SimonD5/GyroBot/Documentation/rapport/Gyrobot_meeting_report.pdf

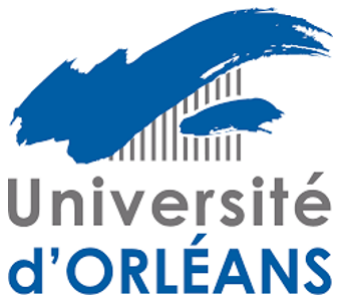
[picture p5: figure]
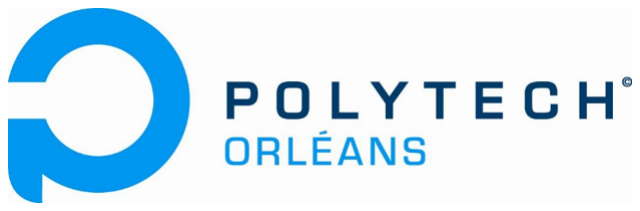
[picture p6: figure]

# Gyrobot meeting report

Alexandre Vanpeperstraëte–Bourgueil Isam Ben-Haddou
Maud Haas
Simon Drapeau

4A GPSE

Quentin Legros

Teacher at Polytech specialising in GPSE

Gyrobot project
Quentin LEGROS
S7 2026

## Contents

1 Meeting on 21 September 2026 | 2
2 Meeting on 2 October 2026 | 2
3 Meeting on 16 October 2026 | 2
4 Meeting on 6 November 2026 | 2

Alexandre Vanpeperstraëte–Bourgueil, Isam Ben-Haddou, Maud Haas, Simon Drapeau

Gyrobot project
Quentin LEGROS
S7 2026

## 1 Meeting on 21 September 2026

At this first meeting, we presented our project and outlined where we were in the process. We also discussed the technical choices regarding the components, particularly the reasoning behind them.

Mr Legros also advised us to carry out a simulation whilst we awaited delivery of the components, to avoid wasting time and, above all, to save time for the next stages, particularly regarding the PID.

It was agreed that, from this Friday onwards, meetings would be held every two weeks unless otherwise requested by the group or Mr Legros.

## 2 Meeting on 2 October 2026

At this second meeting, we presented a simulation of the robot balancing on its two ‘wheels’. We also drafted the use case report.

We also requested a switch to GitHub instead of GitLab, as the latter blocks connections from outside the university network. Furthermore, GitLab will no longer be accessible (and is not accessible at the time of writing this report) and will no longer be usable for the project.

## 3 Meeting on 16 October 2026

This meeting demonstrated the excellent progress made on the project. Indeed, a miniature robot has been built (as required for the next stage of the project), which can balance on two wheels, albeit with a few glitches. Mr Legros therefore gave us some pointers on how to resolve these issues.

A working remote control was also demonstrated. It is already able to control the small robot and allows us to carry out tests for the main robot.

## 4 Meeting on 6 November 2026

At this meeting, we informed Mr Legros that the PCB and the 3D-printed shell for our main robot are being manufactured as planned.

Gyrobot project
Quentin LEGROS
S7 2026

Finally, to save time, he advised us to actively divide up the tasks throughout the project, namely drafting the various deliverables, assisting with the development and implementation of the LiDAR, and preparing for the upcoming presentations.
