SimonD5/GyroBot/Documentation/rapport/Gyrobot_use_cases_report_fait_avec_latex.pdf

# Gyrobot use cases report

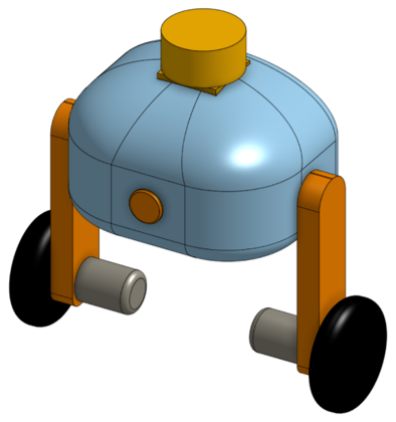
[picture p7: figure]

Alexandre Vanpeperstraëte–Bourgueil Isam Ben-Haddou
Maud Haas
Simon Drapeau

4A GPSE

Quentin Legros

Teacher at Polytech specialising in GPSE

Gyrobot project
Quentin LEGROS
S7 2026

## Summary

1 Introduction | 2
2 General description of the robot | 3
3 User experience | 4
4 Algorithmic operation | 6
5 Specifications | 7
6 Retro planning (Gantt) | 8
7 Validation testing and functional analysis | 10
8 Description of technical choices | 20
9 Gyrobot | 25
10 RSE | 29
11 FMEA Table | 30
12 Conclusion | 33
13 Appendices | 34

Alexandre Vanpeperstraëte–Bourgueil, Isam Ben-Haddou, Maud Haas, Simon Drapeau

Gyrobot project
Quentin LEGROS
S7 2026

## 1 Introduction

As part of our fourth year at Polytech Orléans engineering school, we are required to undertake one of the projects provided or to propose one of our own. We therefore proposed to build a robot that balances on two wheels using a gyroscope: the Gyrobot.

It is a compact, self-balancing, two-wheeled robot, designed to operate in environments where mobility, accessibility, and autonomous navigation can pose challenges.

The project aims to explore the design of a small, lightweight robotic platform capable of maintaining its balance on two wheels, whilst serving as a basis for future applications such as mapping, exploration, and assistance in challenging environments.

In this report, we will cover the general description of the robot, the user experience, the algorithmic operation, the use case, and finally the Gantt chart.

Gyrobot project
Quentin LEGROS
S7 2026

## 2 General description of the robot

The robot can be divided into three main parts:

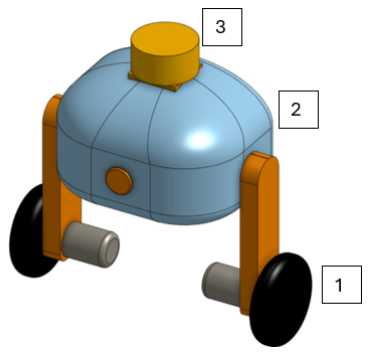
[picture p8: figure]

Figure 1: 3D sketch of the Gyrobot

The lower part of the robot, the motors, wheels and ‘legs’ marked 1 in the image below. This part must be robust so it can withstand the rigours of various types of terrain, as well as the impacts caused by the robot’s movement.

The central section of the robot, labelled 2, contains the various components required for movement, balance, and processing of lidar data. It also houses the battery needed to power the robot. The biggest challenge with this section will be managing the weight and its distribution.

The upper section of the robot, designated 3, will house a tool required for mapping. This section must include at least two different tools in order to make the robot more versatile.

The project also includes a user interface to display the data transmitted and processed by the robot.

Gyrobot project
Quentin LEGROS
S7 2026

## 3 User experience

This section focuses on what the user needs to do to use our product.

### 3.1 Essential feature of the map

The Gyrobot will need to move around, map its surroundings, process the data and send it back to a user interface. It will also need to receive the commands required to move the robot. That is why we have opted to use two cards, to avoid a potential data overload if there were only one card.

A map will need to manage commands relating to the robot’s movements. It must therefore:

- To be able to transmit the commands required for movement wirelessly
- Transmit data such as speed, the robot’s angle relative to the ground and remaining battery charge
- Heat resistance
- To be fairly small in size
- To be energy-efficient

The second card will be responsible for processing mapping-related data and sending it to our HMI. It will therefore need to:

- To have sufficient computing power to process lidar data
- To be able to communicate wirelessly with the HMI
- Heat resistance
- To be fairly small in size
- To be energy-efficient

There are various boards to choose from: an Arduino, an ESP 32, a Raspberry Pi, an STM 32 and a Tensy.

The selection of the various components is carried out in: Description of technical choices

Gyrobot project
Quentin LEGROS
S7 2026

### 3.2 HMI

We also need to develop a user interface to display the data returned by the robot. The image below was created partly with the help of generative AI.

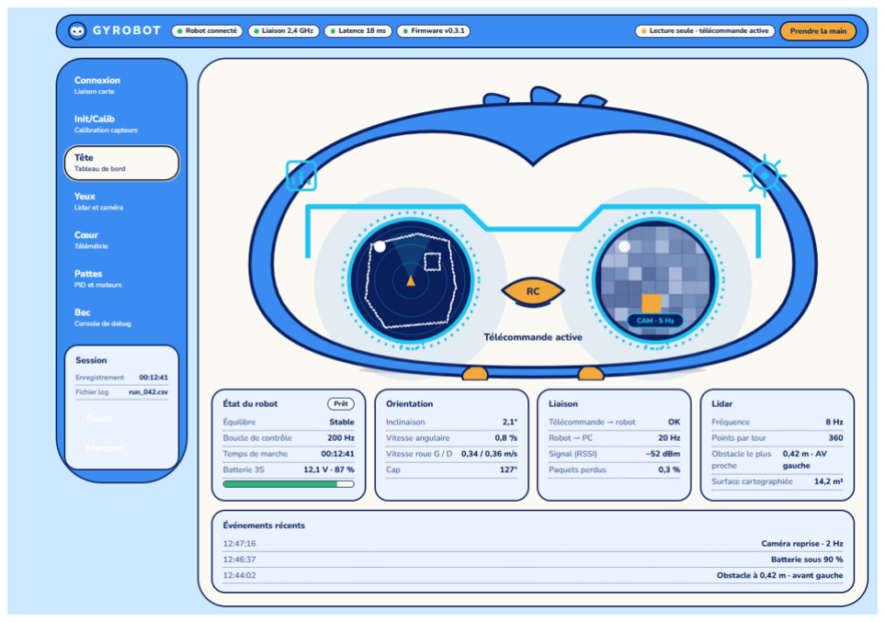
[picture p9: figure]

Figure 2: Image from the IMH

The user interface will comprise several sections/tabs to monitor the various values and lidar data returned by the robot. This penguin-themed user interface was chosen by our team and is purely for aesthetic purposes.

The layout and the data displayed in the user interface are subject to change.

Gyrobot project
Quentin LEGROS
S7 2026

## 4 Algorithmic operation

### 4.1 Flow chart

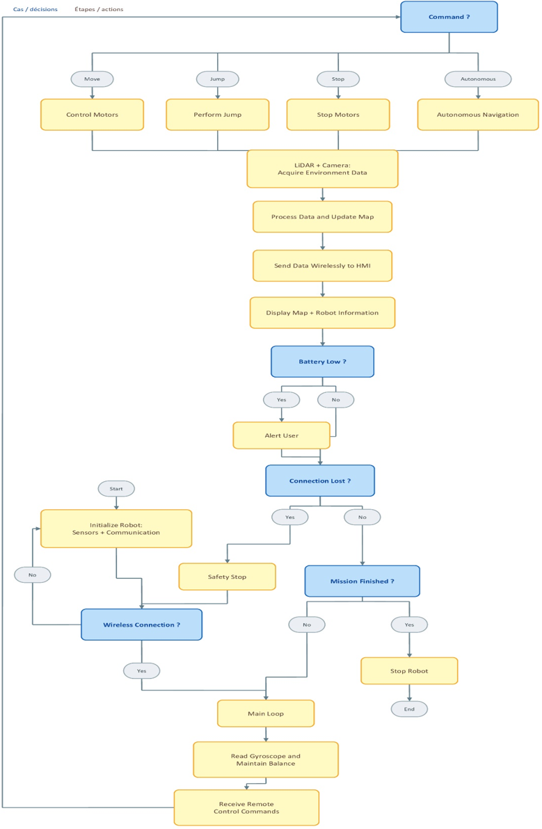
[picture p10: figure]

Figure 3: Flowchart of the Gyrobot

This flowchart explains how the programme’s algorithm works.

Gyrobot project
Quentin LEGROS
S7 2026

## 5 Specifications

In order to draw up the specifications correctly, we need to identify the project’s requirements and expectations. As regards expectations, we need to build a robot that can balance on two wheels, is capable of mapping its environment, and can interact via a remote control and a user interface that displays the robot’s data. As for the requirements, we have defined two types: primary requirements, which are necessary for the robot’s basic operation, and secondary requirements, which serve to make the robot more versatile.

The primary requirements align with our expectations, as we have set them ourselves.

As for the secondary requirements, we wish to develop a user interface and a robot resembling a penguin, to have a rechargeable battery, and for the lidar to be replaceable with a high-resolution camera.

Gyrobot project
Quentin LEGROS
S7 2026

## 6 Retro planning (Gantt)

Phase Task Owner Start End Duration (days) 31/08 07/09 14/09 21/09 28/09 05/10 12/10 19/10 26/10 02/11 09/11 16/11 23/11 30/11 07/12 14/12 21/12 28/12 04/01 11/01

T0: Project kickoff 2026-09-03 2026-09-03 1

Update GitLab All 2026-09-03 2026-10-05 33 Write the ReadMe Simon 2026-09-03 2026-09-08 6
Create the various diagrams All 2026-09-04 2026-09-22 19
Identify the project's HVA functions All 2026-09-15 2026-09-29 15

Specifications document Issam 2026-09-21 2026-09-30 10
CSR approach Maud 2026-09-30 2026-10-04 5 Write the T1 technical report (Audit) Alexandre 2026-09-28 2026-10-05 8
Prepare the PPT (critical path) All 2026-09-30 2026-10-05 6

T1: Audit 2026-10-06 2026-10-06 1
Detail the Phase T1 Gantt chart To be defined 2026-10-06 2026-10-07 2

Select components and place order Maud & Simon 2026-09-29 2026-10-15 17

Generate and evaluate technical solutions for each function To be defined 2026-10-06 2026-10-19 14
Advance system's 3D mechanical design (sizing, architecture) To be defined 2026-10-13 2026-11-03 22

Gestion PCB (Conception & Routage) To be defined 2026-10-06 2026-10-26 21

Validation PCB To be defined 2026-10-27 2026-11-09 14
Justify chosen technical solutions + CSR component To be defined 2026-11-03 2026-11-19 17
Preliminary HVA review + technical report update (PDR) To be defined 2026-11-02 2026-11-20 19
T2: PDR 2026-11-20 2026-11-20 1
Detail the Phase T2 Gantt chart To be defined 2026-11-20 2026-11-21 2

Test composants To be defined 2026-11-23 2026-11-27 5
Manufacture / Assemblage Robot To be defined 2026-11-30 2026-12-04 5

Tenir debout (Asservissement / Équilibrage) To be defined 2026-12-07 2026-12-11 5

LiDAR - Acquisition & Traitement To be defined 2026-11-23 2026-12-04 12
Caméra 3D & Écriture code Python (récup data) To be defined 2026-11-23 2026-12-04 12

Intégration fonctionnalités Caméra + LiDAR To be defined 2026-12-07 2026-12-18 12
Rendre fonctionnelle l'IHM + Rapport IHM To be defined 2026-12-07 2026-12-18 12
Tout intégrer (Matériel + Logiciel) To be defined 2026-12-21 2027-01-01 12

Test each function against requirements (compliance matrix) To be defined 2026-12-15 2027-01-05 22
Fix identified defects To be defined 2027-01-04 2027-01-07 4

Prepare HVA demonstration (CDR) + marketing video (English) To be defined 2026-12-15 2027-01-07 24 Write final S1 technical report To be defined 2026-12-15 2027-01-07 24
T3: CDR + Mini trade show 2027-01-08 2027-01-08 1

Gyrobot Gantt Chart

T0 Kickoff: 09/03/26 | T1 Audit: 10/06/26 | T2 PDR : 20/11/26 | T3 CDR + Mini trade show : 08/01/27

Phase A: Scoping and Analysis Phase B: Design and Technical

Solutions

Phase C: Integration and HVA

Validation

Figure 4: Gantt chart (updated on 21 September 2026)

Gyrobot project
Quentin LEGROS
S7 2026

This schedule will be updated as we make progress on the project. In terms of organisation, our biggest challenge is that we only have three months to build a prototype.
This means we need to have a very precise and rigorous organisational structure.

Gyrobot project
Quentin LEGROS
S7 2026

## 7 Validation testing and functional analysis

### 7.1 Functional analysis

### 7.1.1 Horned beast diagram

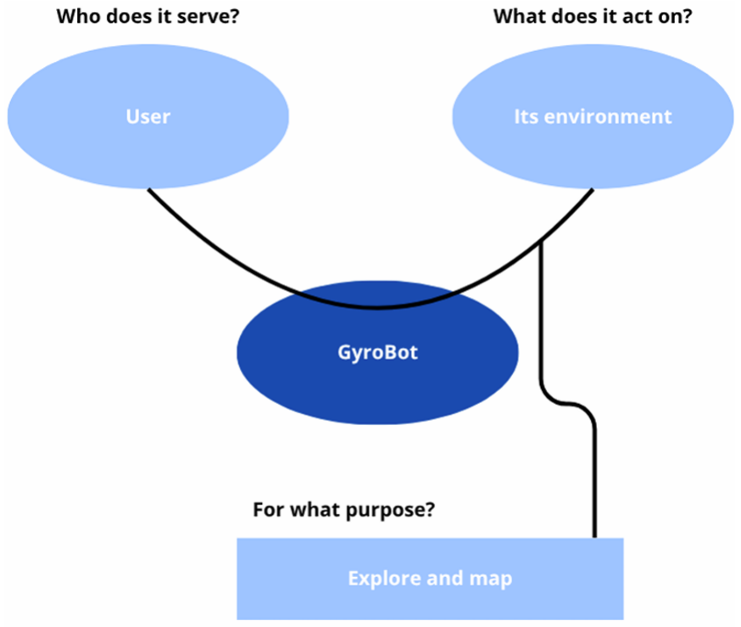
[picture p11: figure]

Figure 5: Horned beast diagram

The horned beast diagram provides a clear understanding of a user’s needs before designing a product or service. In our case, our aim is to map an area and create a map of it, all using the Gyrobot. It will be controlled by a user in various environments, both indoors and outdoors.

Gyrobot project
Quentin LEGROS
S7 2026

### 7.1.2 Octopus diagram

Here are the various block diagrams showing the critical and main functions.

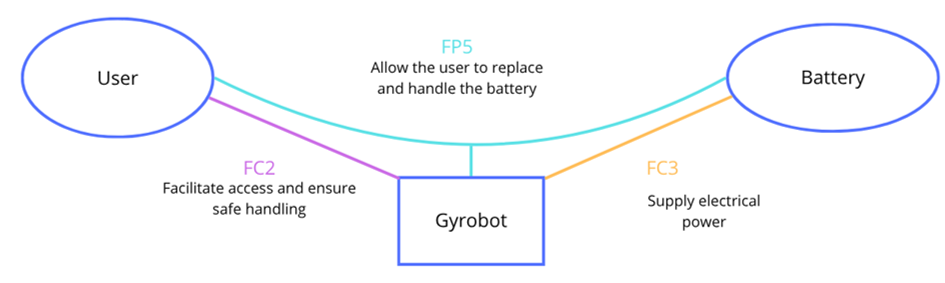
[picture p12: figure]

Figure 6: Energy recharge phase

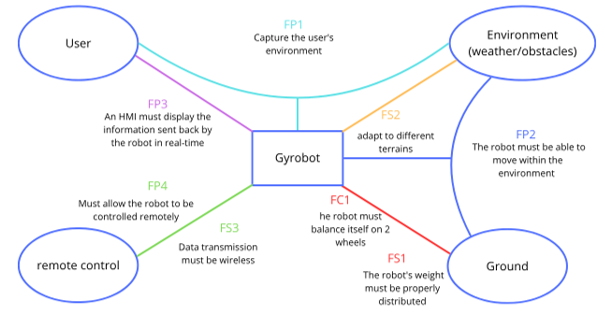
[picture p13: figure]

Figure 7: Usage phase

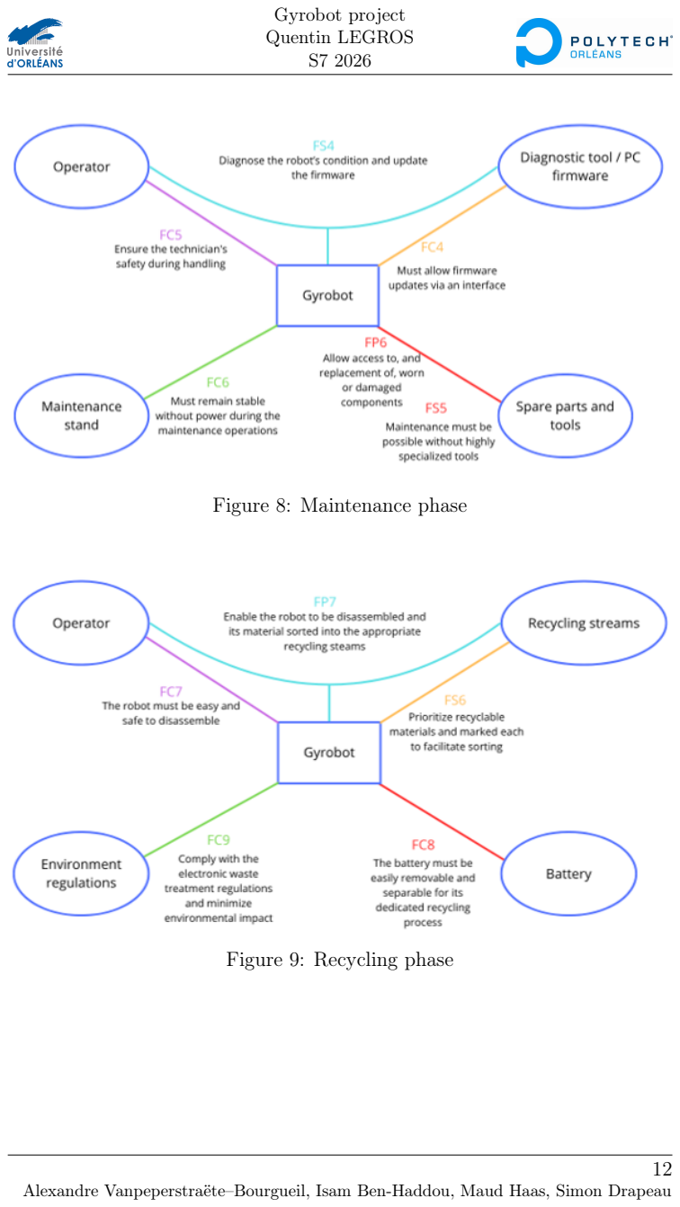
[picture p14: page 13]

Gyrobot project
Quentin LEGROS
S7 2026

Figure 8: Maintenance phase

Figure 9: Recycling phase

Gyrobot project
Quentin LEGROS
S7 2026

### 7.1.3 FAST diagrams

Using octopus diagrams, we obtain the FAST diagram.

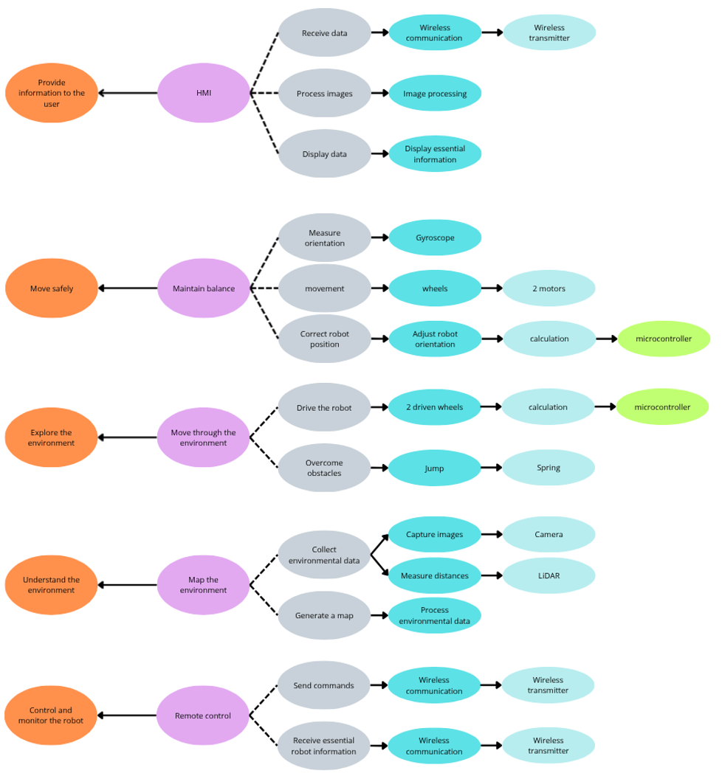
[picture p15: figure]

Figure 10: Fast diagrams

The FAST diagram enables us to work our way from our requirements to the technical solutions.

Gyrobot project
Quentin LEGROS
S7 2026

### 7.2 Functional table

Using the FAST diagram, we can draw up a functional diagram of the Gyrobot.

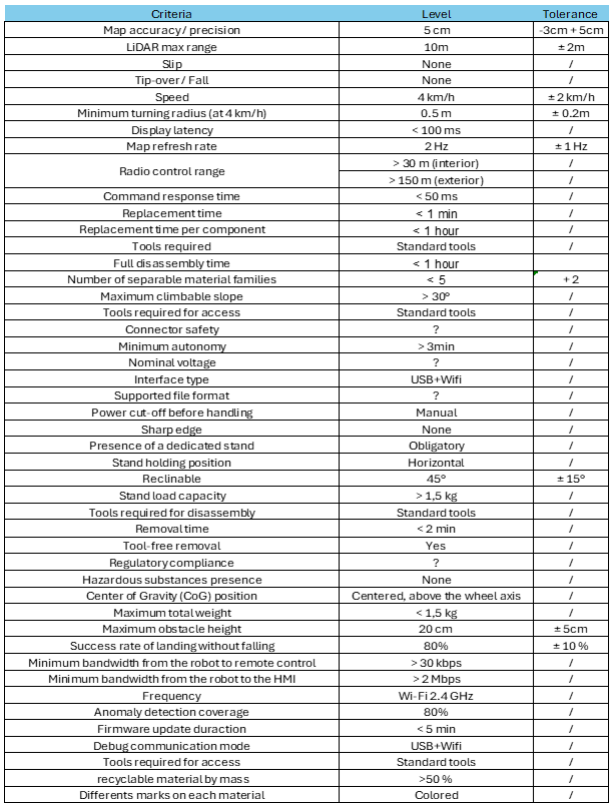
[picture p16: figure]

Figure 11: Functional analysis

Gyrobot project
Quentin LEGROS
S7 2026

### 7.3 Validations test

To avoid building the robot from scratch only to find that it doesn’t work without knowing why, we need to put validation tests in place to test each major component of the robot separately.

Here are the various tests that have been put in place:

- Connection and acknowledgement test
- Command response time test
- Remote control range test
- Communication reliability test
- Data rate and range test to the computer
- Lidar range test
- Map accuracy test
- Display latency and map refresh rate test
- Balance test
- Speed and turning radius test
- Weight test
- Battery replacement test
- Simultaneous operation test

### 7.3.1 Connection and acknowledgement test

We send commands from the remote control and check that the ESP32 receives them and sends back an acknowledgement. The test is successful if the green dot remains lit on the remote control.

### 7.3.2 Testing the response time of the control system

The remote control records the time a command is sent and the time the acknowledgement is received. The difference gives the response time, which

Gyrobot project
Quentin LEGROS
S7 2026

must be less than 50 ms. The statistics are displayed in a ‘Statistics’ tab on the remote control, and the mean and standard deviation are monitored.

Gyrobot project
Quentin LEGROS
S7 2026

### 7.3.3 Remote control range test

Gradually move the remote control away from the robot, first indoors and then outdoors, with and without obstacles. Record the distance once the connection is lost. The test is successful if the connection remains stable for more than 30 metres indoors and more than 150 metres outdoors. Check the green dot and the number of lost packets in the ‘Stats’ tab on the remote control.

### 7.3.4 Transaction reliability test

Leave the robot to run for 1 minute, whilst moving it around, and note the number of lost packets in the ‘Statistics’ tab on the remote control, then in the HMI. The test is successful if the loss rate remains below 5 per cent.

### 7.3.5 Testing the data rate and range to the computer

Measure the actual data transfer rate between the Raspberry Pi and the computer. The data transfer rate must remain above 2 Mbps.

### 7.3.6 Lidar range test

An obstacle is placed at increasing distances from the robot, and we check whether it appears on the HMI map. The maximum range should be 10 m ± 2 m. We compare the distance displayed on the HMI with the measured distance to verify reliability at each distance.

### 7.3.7 Map accuracy test

We have a room or object mapped, having first measured its dimensions. We then compare the dimensions shown on the map with those in reality. The test is deemed successful if the deviation falls within the tolerance specified in the specifications (5 cm, -3 / +5 cm).

Gyrobot project
Quentin LEGROS
S7 2026

### 7.3.8 Testing the display latency and refresh rate of the graphics

card

The Raspberry Pi stamps each data point with a timestamp upon acquisition, and the computer compares this timestamp with the display time, after synchronising the two. The latency must be less than 100 ms. To calculate the refresh rate, we count the number of map updates over 10 seconds, which should give 2 Hz ± 1.

### 7.3.9 Balance test

The robot is left stationary and then set in motion for several minutes, whilst being given gentle nudges. The robot must neither fall over nor slip. We also check that it can climb up and down a slope steeper than 30°.

### 7.3.10 Speed and turning circle test

A distance of 10 m is marked out and the time taken to cover this distance at maximum speed is recorded: 4 km/h corresponds to approximately 9 s, with a margin of error of ± 2 km/h. To test the cornering, the robot is made to trace a circle, and its radius is measured (0.5 m ± 0.2 m). A visual check is carried out to ensure there is no slippage.

### 7.3.11 Weight test

We weigh the complete robot, including the battery, on a set of scales: it must weigh less than 1.5 kg.

### 7.3.12 Battery replacement test

Someone who did not design the robot replaces the battery, timing the process, without using any tools. The replacement must take less than a minute. A check is then carried out to ensure the robot restarts correctly.

Gyrobot project
Quentin LEGROS
S7 2026

### 7.3.13 Simultaneous testing

We run everything at the same time: balance, movement, controls, Lidar, camera and data transmission to the computer. We monitor the stats tabs for several minutes. The test is successful if the robot does not fall over and if all the previous criteria are met.

Gyrobot project
Quentin LEGROS
S7 2026

## 8 Description of technical choices

### 8.1 Remote control

Criterion | Level | Unit | Source
Minimum radio range (indoor) | 30 | m | Specifications : function table (FP4)
Minimum radio range (outdoor) | 150 | m | Specifications : function table (FP4)
Maximum response time of the control | 50 | ms | Specifications : function table (FP4)
Control element | No. of elements | Analog. channels / element | Digital inputs / element | Digital outputs / element | I2C pins / element | Total analog | Total digital inputs | Total digital outputs | Total I2C pins | Role on the robot (to be completed)
2-axis joystick (KY-023) | 2 | 2 | 1 | 0 | 0 | 4 | 2 | 0 | 0 | Joystick 1 : forward/backward (Y axis) + turn right/left (X axis) ; Joystick 2 : tilt right/left (X axis) + lower/raise (Y axis)
Slide potentiometer | 3 | 1 | 0 | 0 | 0 | 3 | 0 | 0 | 0 | Adjustment of the robot's 3 PID controller gains (P, I, D)
Rotary potentiometer | 1 | 1 | 0 | 0 | 0 | 1 | 0 | 0 | 0 | Adjustment of the maximum travel speed
Push button | 5 | 0 | 1 | 0 | 0 | 0 | 5 | 0 | 0 | 1 button = jump ; 4 buttons = macros / screen navigation
Signal LED | 1 | 0 | 0 | 1 | 0 | 0 | 0 | 1 | 0 | Power-on status
OLED screen (I2C) | 1 | 0 | 0 | 0 | 2 | 0 | 0 | 0 | 2 | Menu navigation, communication parameter settings, robot information display (speed, battery,…)
On / off switch | 1 | 0 | 0 | 0 | 0 | 0 | 0 | 0 | 0 | In series with the power supply
Digital voltmeter | 1 | 0 | 0 | 0 | 0 | 0 | 0 | 0 | 0 | Connected to the battery
TOTAL | | | | | | 8 | 7 | 1 | 2
Indicator | Value | Comment
Analog channels to acquire | 8 | 2 joysticks × 2 axes + 3 sliders + 1 rotary
Digital inputs (buttons) | 7 | 5 buttons + 2 buttons integrated into the joysticks
Digital outputs | 1 | Signal LED
I2C pins (SDA + SCL) | 2 | OLED screen
Total GPIO pins required | 18 | The microcontroller must provide at least this number of usable GPIOs
Values to be transmitted per radio frame | 15 | Analog channels + button states (to be sent to the robot)
Minimum transmission frequency (Hz) | 20 | At least 1 complete transmission per maximum response time
Selected transmission frequency (Hz) | 50 | Assumption : 50 Hz (×2.5 margin over the minimum)
Transmission period (ms) | 20,0 | Maximum delay between two frames
Estimated radio latency + robot processing (ms) | 10 | Assumption : ESP-NOW ≈ a few ms + robot-side reading
Estimated response time (ms) | 30,0 | Transmission period + latency

Remote control – Needs analysis (FP4)
FP4 : the remote control must be able to pilot the robot remotely

### 1. Criteria of function FP4 (from the specifications)

### 2. Input/output needs of the remote control (based on the electronic diagram)

### 3. Summary : what the remote control must provide (microcontroller selection criteria)

Figure 12: Remote control

Gyrobot project
Quentin LEGROS
S7 2026
No. | Function performed | Componen t selected | Reference / model | Main characteristics | Justification of choice | Alternatives considered | Alternative drawbacks | Qty | Unit price (€) | Total price (€)
1 | Command processing (acquisition, computation, screen interface) | Microcontrol ler | ESP32-S3-DevKitC-1-N16R8 | Dual-core Xtensa LX7 240 MHz · 16 MB Flash + 8 MB PSRAM, 3.3 V logic supply, many GPIOs including 10 channels usable on ADC1 | Enough GPIOs and ADC1 channels for the 18 pins required (see sheet « Requirements »). | Arduino Nano | No built-in radio, little memory, fewer ADC inputs | 1 | 8,00 € | 8,00 €
| | | | | | ESP32-S3 version N8R2/N8R8 | Less Flash/PSRAM, lower memory margin
| | | | | | STM32 | More processing power but radio and Wi-Fi must be added as an external module
2 Radio link control | → robot | Communica tion protocol | ESP-NOW (2.4 GHz Wi-Fi, native on the ESP32-S3) | Typical latency of a few ms, potential range with this board : > 200 m outdoor with no obstacles, > 100 m outdoor with obstacles, > 20 m indoor | Latency compatible with the required response time (< 50 ms). Built into the ESP32-S3 : no external radio module to wire. | Detailed comparison against other solutions in the sheet « Radio Comparison ».
3 | Proportional control of movement and orientation | 2-axis joystick | Module KY-023 | 2 10 kΩ potentiometers (X and Y axes) + built-in push button, 3.3-5 V supply | Proportional analog signal. Joystick 1 = forward/backward (Y axis) and turn right/left (X axis) ; Joystick 2 = tilt right/left (X axis) and lower/raise (Y axis). | Directional buttons | On/off only, no gradual control | 2 | 4,00 € | 8,00 €
4 | Proportional adjustment of the controller gains | Slide potentiomet er | Linear slide potentiometer | 10 kΩ linear resistive track, 3 pins | PID position readable at a glance, gradual and precise adjustment, 1 analog channel each. | potentiometer Rotary | Less readable | 3 | 1,60 € | 4,80 €
| | | | | | Incremental encoder | More connectors used per value to change
5 Speed adjustment | | Rotary potentiomet er | VRB-101M10 | 10 kΩ, 3 pins | Gradual and compact adjustment, easy to read for speed | Slide potentiometer | Bulkier and less readable | 1 | 0,50 € | 0,50 €
| | | | | | Rotary encoder | No physical stop, more connectors used
| | | | | | Toggle switch | Does not natively return to its initial position

Remote control - Component selection
Justification of each component with respect to function FP4 (piloting the robot remotely)
6 | 0,30 € | 1,50 € On/off commands
and macros | Push button | BP-GT1-ON

Momentary open contact, read
with the ESP32's internal pull- | Simple, reliable, low-cost, 1 digital input
each, with no additional external component. | 5

Figure 13: Remote control – Component selection

Gyrobot project
Quentin LEGROS
S7 2026
Criterion | Unit | ESP32-S3 + ESP-NOW | Arduino Nano + nRF24L01 (PA/LNA) | Arduino + LoRa (SX1278) | Bluetooth module HC-05
Frequency band | | 2.4 GHz | 2.4 GHz | 433 / 868 MHz | 2.4 GHz
Typical outdoor range (direct line of sight) | m | 200 | 800 | 2000 | 10
Typical link latency | ms | 5 | 3 | 200 | 30
Meets the FP4 outdoor range ? | | YES | YES | YES | NO
Meets the FP4 response time ? | | YES | YES | NO | YES
Compliant with function FP4 ? | | YES | YES | NO | NO
Criterion | Weight | ESP32-S3 + ESP-NOW | Arduino Nano + nRF24L01 (PA/LNA) | Arduino + LoRa (SX1278) | Bluetooth module HC-05
Outdoor range | 25% | 4 | 5 | 5 | 1
Latency / responsiveness | 20% | 5 | 5 | 1 | 3
Number of I/Os and analog channels | 15% | 5 | 3 | 3 | 3
Ease of implementation (wiring, code) | 15% | 4 | 3 | 2 | 4
Cost | 10% | 5 | 4 | 2 | 4
Power consumption | 10% | 3 | 4 | 4 | 3
Integration / size | 5% | 5 | 3 | 2 | 3
Total weight (must equal 100 %) | 100%
Score out of 20 | | 17,6 | 16,4 | 11,6 | 11,0
Score retained (0 if not compliant with FP4) | | 17,6 | 16,4 | 0,0 | 0,0
Rank | | 1 | 2 | 3 | 3
Decision | | SELECTED | Not selected | Eliminated (FP4) | Eliminated (FP4)

Remote control – Comparison of radio / microcontroller solutions
Choice of the wireless link solution (FP4 elimination criteria, then weighted scoring)
A. Solutions considered with typical orders of magnitude and compliance with FP4
B. Weighted scoring (0 = very unfavorable … 5 = very favorable) – indicative scores to be adjusted

Figure 14: Remote control – Comparison of radio/microcontroller solutions

Gyrobot project
Quentin LEGROS
S7 2026 Parameter | Value
Element | Qty | Unit current (mA) | Powered by | Total current (mA) | Assumption / source
ESP32-S3 (ESP-NOW transmission) | 1 | 120 | 5 V rail | 120,0 | Average during Wi-Fi transmission -> higher peaks
OLED screen 0.96" SSD1306 | 1 | 20 | 5 V rail | 20,0 | Screen on and changing image at 2Hz
Joystick KY-023 | 2 | 1 | 5 V rail | 2,0 | 2 10 kΩ potentiometers at 3.3 V ≈ 0.7 mA
Slide potentiometer | 3 | 0,5 | 5 V rail | 1,5 | 10 kΩ at 3.3 V ≈ 0.33 mA
Rotary potentiometer | 1 | 0,5 | 5 V rail | 0,5 | 10 kΩ at 3.3 V ≈ 0.33 mA
Signal LED | 1 | 10 | 5 V rail | 10,0 | LED permanently on
Digital voltmeter | 1 | 10 | 5V rail | 10,0 | Connected to the output of the 7.4V->5V converter
Indicator | Value | Comment
Total current on the 5 V rail (mA) | 164,0 | Sum of the elements powered by the converter
Power on the 5 V rail (mW) | 820 | P = U * I
Current drawn from the battery (mA) | 138,5 | Rail power referred back to the battery (efficiency included)
Estimated battery life (h) | 2,9 | Usable capacity / current drawn
Max. LM2596 current (mA) | 3 000 | Manufacturer value : 3 A
Voltage margin Vbattery − Voutput (V) | 2,4 | The LM2596 requires a minimum input difference of about 2 V
Sufficient voltage margin ? | YES | To be checked when the battery is discharged

Remote control – Energy balance and battery life
Justifies the choice of the LiPo battery and the LM2596 converter

### 1. Power supply parameters

| | Comment
Nominal battery voltage (V) | 7,4 | Battery selected : 2S LiPo (7.4 V nominal)
Battery capacity (mAh) | 500 | Battery selected : 2S 500 mAh LiPo
Usable capacity fraction | 80% | Assumption : 80 % (to avoid fully discharging the battery)
LM2596 output voltage (V) | 5,0 | Set to 5 V to power the ESP32 board
Converter efficiency | 80% | Assumption : 85 % (typical 80–90 % for an LM2596)

### 2. Element power consumption

### 3. Results

Figure 15: Remote control – Energy balance and battery life

Gyrobot project
Quentin LEGROS
S7 2026

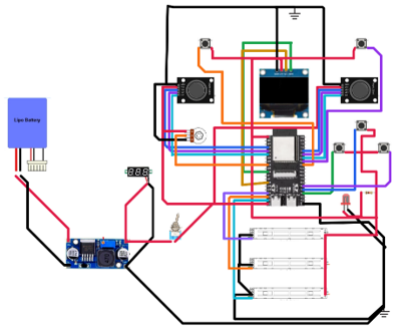
[picture p17: figure]

Figure 16: Electronic schematic for the remote

Gyrobot project
Quentin LEGROS
S7 2026

## 9 Gyrobot

### 9.1 Motor selection

### 1. Data and formulas

Data

- Maximum robot mass: M = 1.3 kg
- Gravitational acceleration: g = 9.81 m/s²
- Number of motors: 2 identical motors
- Specifications requirement: Nominal speed v ∈ [2.0; 6.0] km/h (4 ± 2 km/h)
- Fall prevention criterion: Minimum acceleration amax > 9.81 m/s²

(1.0 g)

Formulas

1. Angular speed: ω = N × (2π/60) (rad/s)
2. Max linear speed: vmax = ω × R (m/s) = 3.6 × (ω × R) (km/h)
3. Total ground thrust (2 motors): F =

2×τstall
R

(N)

4. Max acceleration: amax =

F
M

(m/s²
) and Margin in g =

amax
9.81
Characteristics of the 3 motors
- Motor 1 (FIT0520): N = 300 RPM (ω = 31.42 rad/s), τ = 3.6 kg · cm = 0.353 N · m (2τ = 0.706 N · m)
- Motor 2 (FIT0521): N = 210 RPM (ω = 21.99 rad/s), τ = 10.0 kg · cm = 0.981 N · m (2τ = 1.962 N · m)
- Motor 3 (FIT0522): N = 100 RPM (ω = 10.47 rad/s), τ = 6.5 kg · cm = 0.637 N · m (2τ = 1.275 N · m)

### 2. Maximum speed calculations (vmax)

Speed conclusion:

Gyrobot project
Quentin LEGROS
S7 2026
Motor | R = 3.5 cm | R = 4.0 cm | R = 5.0 cm | R = 6.0 cm
FIT0520 (300 RPM) | 3.96 km/h | 4.52 km/h | 5.66 km/h | 6.79 km/h (Too fast)
FIT0521 (210 RPM) | 2.77 km/h | 3.17 km/h | 3.96 km/h | 4.75 km/h
FIT0522 (100 RPM) | 1.32 km/h | 1.51 km/h | 1.88 km/h | 2.26 km/h

Table 1: Maximum linear speed as a function of wheel radius (allowed range:
2 to 6 km/h).
- FIT0522 (100 RPM): Eliminated. Far too slow for wheel radii from 3.5 to 5 cm (< 2.0 km/h, non-compliant with specifications).
- FIT0520 (300 RPM): Compliant up to 5 cm, but exceeds the maximum speed limit at 6 cm (6.79 km/h > 6.0 km/h).
- FIT0521 (210 RPM): Compliant. Strictly within the required [2.0− 6.0] km/h range for all evaluated radius.

### 3. Maximum Acceleration Calculations (amax for M = 1.3 kg)

Total thrust is F = (2 × τ )/R and acceleration is amax = F/1.3

Motor | R = 3.5 cm | R = 4.0 cm | R = 5.0 cm | R = 6.0 cm
FIT0520 (3.6 kg · cm) | 15.5 m/s² (1.58 g) | 13.6 m/s² (1.38 g) | 10.9 m/s² (1.11 g) | 9.0 m/s² (0.92 g) (Fall)
FIT0521 (10.0 kg · cm) | 43.1 m/s² (4.40 g) | 37.7 m/s² (3.85 g) | 30.2 m/s² (3.08 g) | 25.2 m/s² (2.56 g)
FIT0522 (6.5 kg · cm) | 28.0 m/s² (2.86 g) | 24.5 m/s² (2.50 g) | 19.6 m/s² (2.00 g) | 16.4 m/s² (1.67 g)

Table 2: Maximum available acceleration to prevent tipping for a 1.3 kg
robot.

Acceleration conclusion:

- To stabilize the inverted pendulum, the acceleration must strictly exceed gravity (a > 1.0 g = 9.81 m/s²
).
- FIT0520 (3.6 kg · cm): As soon as the radius reaches 6 cm, acceleration drops to 0.92 g (< 1.0 g): the robot cannot recover and tips over. Even at 4 cm (1.38 g), the margin is very narrow.

Gyrobot project
Quentin LEGROS
S7 2026
- FIT0521 (10.0 kg · cm): Delivers between 2.56 g and 4.40 g of acceleration, guaranteeing that the robot will never stall or tip over.

### 4. Selected Choice

1. FIT0522 (100 RPM; 6.5 kg · cm): Rejected because it is far too slow.
2. FIT0520 (300 RPM; 3.6 kg·cm): Rejected due to insufficient torque and risk of balancing failure at 1.3 kg.
3. FIT0521 (210 RPM; 10.0 kg · cm): Selected. The only motor that simultaneously satisfies the speed requirement and provides ample acceleration margin across all radii.
4. Optimal Wheel Radius: R = 3.5 cm to 4.5 cm (diameter of 70 to 90 mm), providing ≈ 3.2 km/h and nearly 4 g of acceleration.

Gyrobot project
Quentin LEGROS
S7 2026

### 9.1.1 electronic schematic

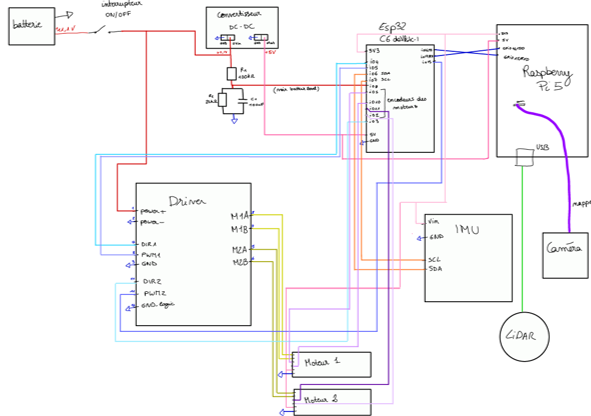
[picture p18: figure]

Figure 17: electronic schematic for the robot

### 9.1.2 Justification of the component’s choices

Open the full Excel file, as it is not possible to insert it neatly into the report. (Gyrobot_Component_Selection.xlsx)

Gyrobot project
Quentin LEGROS
S7 2026

## 10 RSE

The Gyrobot project integrates an eco-design approach to limit our carbon footprint. Instead of making parts far away, all the structure is manufactured locally by 3D printing using PLA, a bio-based and recyclable plastic. To make the sorting easier at the end of life (FS6), recycling symbols are modelled directly in relief on the CAD parts. To go further in accessibility, each material or sorting instruction has its own geometric logo in relief and a colour code. These colours were specifically chosen to be easily seen by colourblind people (yellow, dark blue, white, black, magenta).

For the electronic part, designing and routing a custom motherboard allows us to connect the microcontrollers and components directly through copper tracks. This avoids using dozens of flying wires. It reduces the number of plastic cables used and makes the system much tougher.

The robot was also designed to last in time and to fight against obsolescence (meaning avoiding throwing it away at the first broken component). All the architecture allows us to easily access fragile parts to change them quickly (FP6). The assembly is done using only standard screws, so the structure can be disassembled very simply (FC7) with basic screwdrivers without special tools (FS5). The battery, for example, can be removed very easily to be sent to its specific recycling channel which makes recycling much easier (FC8).

This design choice allows us to respect the European WEEE directive (Waste Electrical and Electronic Equipment) which imposes strict rules to limit the pollution of this kind of system (FC9).

Finally, beyond the environmental impact, the Gyrobot has a real social utility focused on safety at work. The main goal is to map inaccessible, unstable or dangerous places instead of humans. Whether it is to explore a building for a rescue or to inspect unreachable industrial environments, all the necessary spatial data is collected by the robot without ever putting the lives of rescue teams or technicians in danger.

Gyrobot project
Quentin LEGROS
S7 2026

## 11 FMEA Table

FMEA is an analysis table that helps us figure out what could go wrong when our robot is exploring. Since the robot only uses two wheels, keeping its balance and staying connected to the remote are extremely important. This table lists the main problems the system might face. We give each risk a score based on how bad it is (Severity), how often it happens (Frequency) and how hard it is to spot (Detection). This will help us to focus on the biggest dangers so we can figure out the best ways to prevent them.

Gyrobot project
Quentin LEGROS
S7 2026

Table 3: Failure Mode and Effects Analysis (FMEA) for Gyrobot

Subsystem Failure
Mode

Potential
Effect

Potential
Cause
S | F | D | RPN | Corrective Action

Balance
Control

IMU
thermal
drift or
vibration
noise

Loss of
absolute tilt
reference,
robot falls

Motor
vibrations,
temperature
changes
8 3 2 | 48 | Low-noise
| | | | Adafruit LSM6DSOX IMU, software low-pass filter & watchdog

Balance
Control

PID loop
execution
latency

Highfrequency
oscillation,
balance loss

OS
scheduler
jitter or
CPU
overload
9 | 4 | 2 | 72 | Dedicated ESP32-C6 RTOS task (200 Hz
| | | | hard real-time loop)
Propulsion | Motor stall
or torque
saturation

Inability to
recover tilt,
robot tips
over

Steep slope,
low battery
voltage
9 3 3 | 81 | High-torque
| | | | FIT0521 motors (10 kg · cm stall),
| | | | current monitoring
Propulsion | Wheel slip
or traction
loss

Odometry
drift,
balance
instability

Low-friction
or smooth
surface
6 | 4 | 3 | 72 | High-grip TPU 3D-printed tires, wheel speed anomaly filtering

CommunicationESP-NOW
wireless link
drop

Loss of
remote
guidance,
runaway
risk

Radio
interference,
out of range
8 3 2 | 48 | Automatic
| | | | failsafe: motor shutdown after 100 ms without signal

Gyrobot project
Quentin LEGROS
S7 2026

Table 3: Failure Mode and Effects Analysis (FMEA) for Gyrobot

Subsystem | Failure Mode | Potential Effect | Potential Cause | S | F | D | RPN | Corrective Action
Navigation | LiDAR optical obstruction | Collision, incorrect 2D SLAM map | Dust on lens, direct sunlight glare | 6 | 3 | 3 | 54 | Camera redundancy, proximity safety thresholds

Power
Supply

Sudden
LiPo voltage
drop

Microcontroller
reboot,
sudden fall

Deep
discharge,
cell
degradation
10 2 2 | 40 | Hardware cutoff threshold (9.9 V),
| | real-time telemetry alert

Legend:

- G (Severity): 1 to 4
- F (Frequency): 1 (Rare) to 4 (Frequent)
- D (non-detection): 1 (Immediately detectable) to 4 (Hard to predict)
- C (Criticality) = G × F × D

Gyrobot project
Quentin LEGROS
S7 2026

## 12 Conclusion

To conclude, this project is going to be very demanding, particularly in terms of time. Nevertheless, our team has shown great commitment, which is spurring us on to persevere and achieve our goal of producing a prototype before the end of the term, featuring the following key functions:

- To balance,
- Mapping using lidar,
- Move around using a remote control.

Gyrobot project
Quentin LEGROS
S7 2026

## 13 Appendices

## Full summary

1 Introduction | 2
2 General description of the robot | 3
3 User experience | 4
4 Algorithmic operation | 6
5 Specifications | 7
6 Retro planning (Gantt) | 8
7 Validation testing and functional analysis | 10
7.3.2 | Testing the response time of the control system . . . . 15
7.3.5 | Testing the data rate and range to the computer . . . . 17
7.3.8 | Testing the display latency and refresh rate of the graph-

Gyrobot project
Quentin LEGROS
S7 2026
8 Description of technical choices | 20
9 Gyrobot | 25
10 RSE | 29
11 FMEA Table | 30
12 Conclusion | 33
13 Appendices | 34

Gyrobot project
Quentin LEGROS
S7 2026

## List of Figures

1 | 3D sketch of the Gyrobot | | 3
2 | Image from the IMH | | 5
3 | Flowchart of the Gyrobot | | 6
4 | Gantt chart (updated on 21 September 2026) | | 8
5 | Horned beast diagram | 10
6 | Energy recharge phase | 11
7 | Usage phase | 11
8 | Maintenance phase | 12
9 | Recycling phase | 12
10 | Fast diagrams | 13
11 | Functional analysis | 14
12 | Remote control | 20
13 | Remote control – Component selection | 21
14 | Remote control – Comparison of radio/microcontroller solutions 22
15 | Remote control – Energy balance and battery life | 23
16 | Electronic schematic for the remote | 24
17 | electronic schematic for the robot | 28

Gyrobot project
Quentin LEGROS
S7 2026

## List of Tables

1 | Maximum linear speed as a function of wheel radius (allowed
| range: 2 to 6 km/h) | 26
2 | Maximum available acceleration to prevent tipping for a 1.3
| kg robot | 26
3 | Failure Mode and Effects Analysis (FMEA) for Gyrobot . . . 31
3 | Failure Mode and Effects Analysis (FMEA) for Gyrobot . . . 32
