SimonD5/GyroBot/3D/V1_Images/Front.png

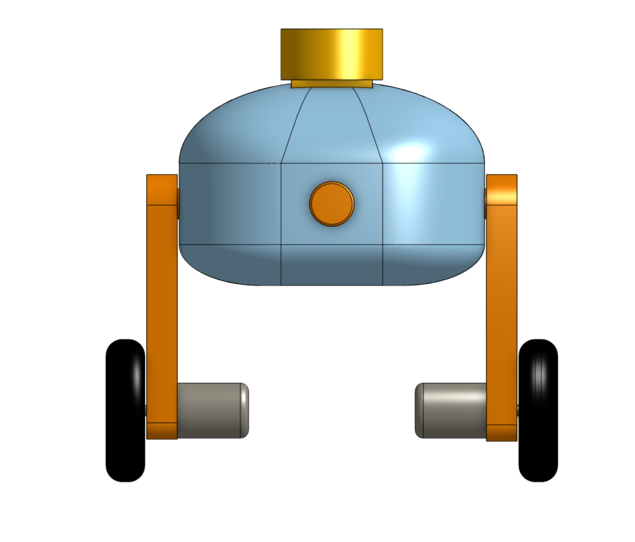
3D/V1_Images/Front.png
