SimonD5/GyroBot/3D/V1_Images/Left.png

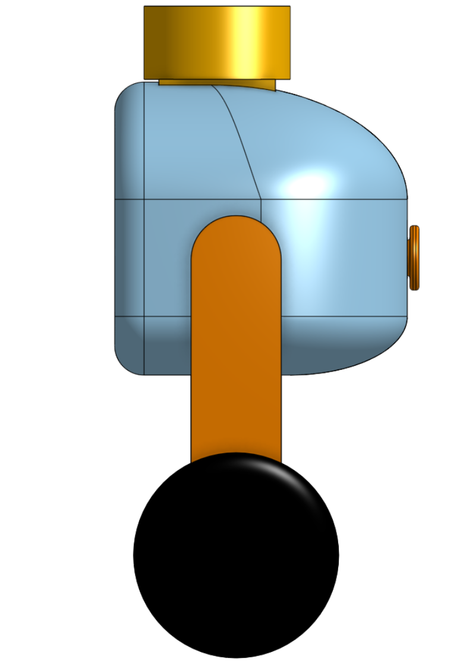
3D/V1_Images/Left.png
