SimonD5/GyroBot/Documentation/Images/Context_diagram__energy_recharge_phase.png

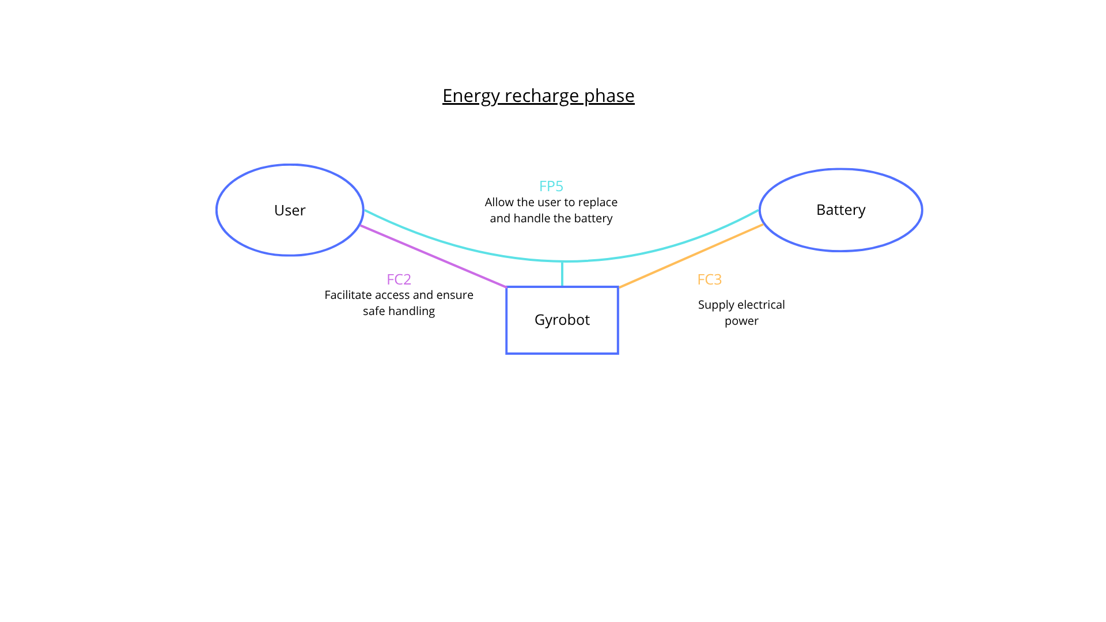
Documentation/Images/Context_diagram__energy_recharge_phase.png
