SimonD5/GyroBot/Documentation/Images/Context_diagram_recycling_phase.png

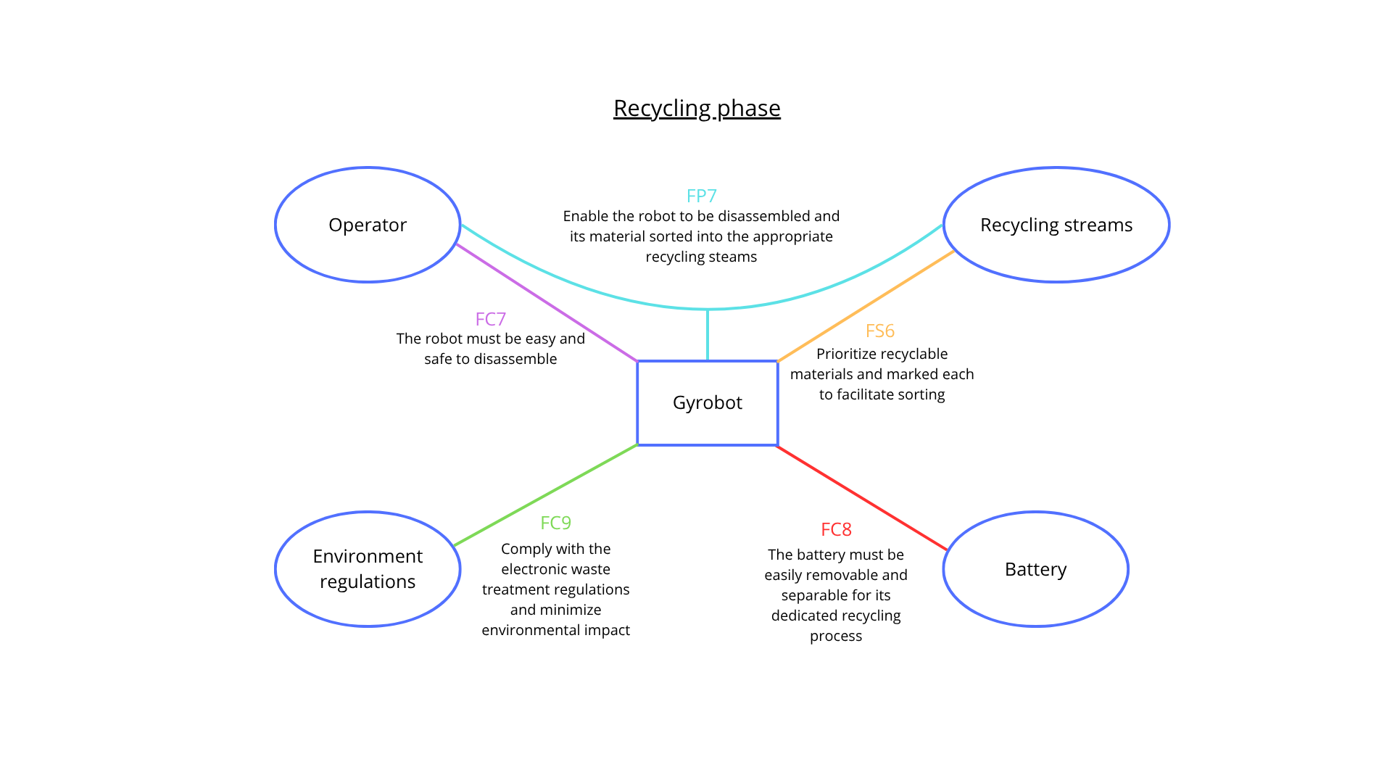
Documentation/Images/Context_diagram_recycling_phase.png
