SimonD5/GyroBot/Remote/3D/Capture_d_écran_2026-09-28_171622.png

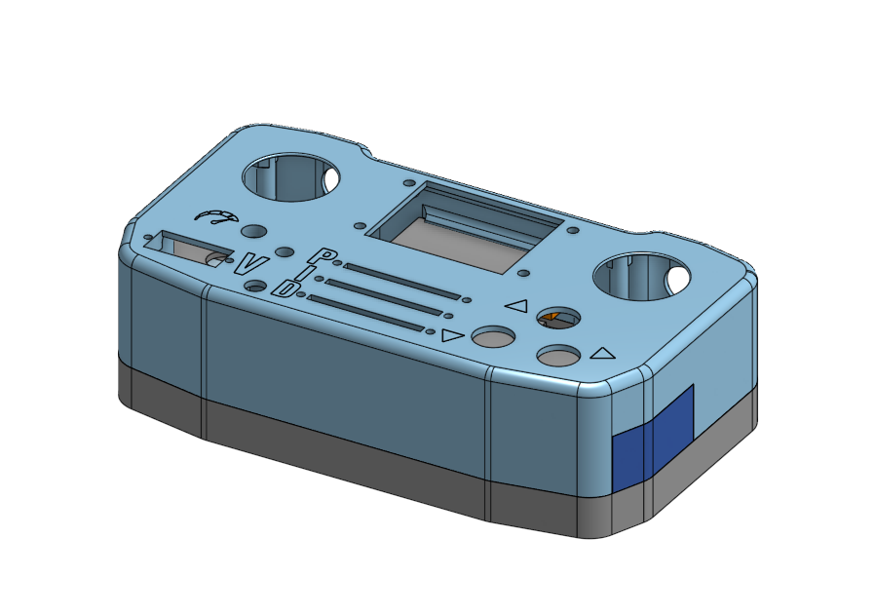
Remote/3D/Capture_d_écran_2026-09-28_171622.png
