SimonD5/GyroBot/Remote/telecommandeSchematic.png

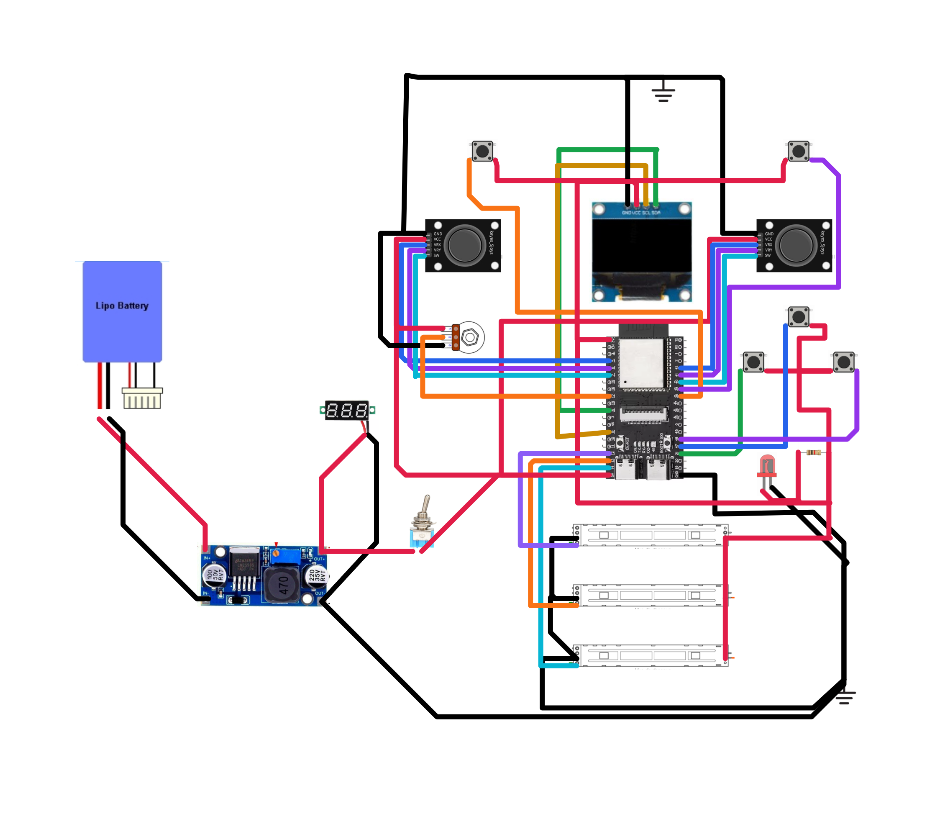
Remote/telecommandeSchematic.png
