SimonD5/GyroBot/Repeteur/3D/V2/V2_picture.png

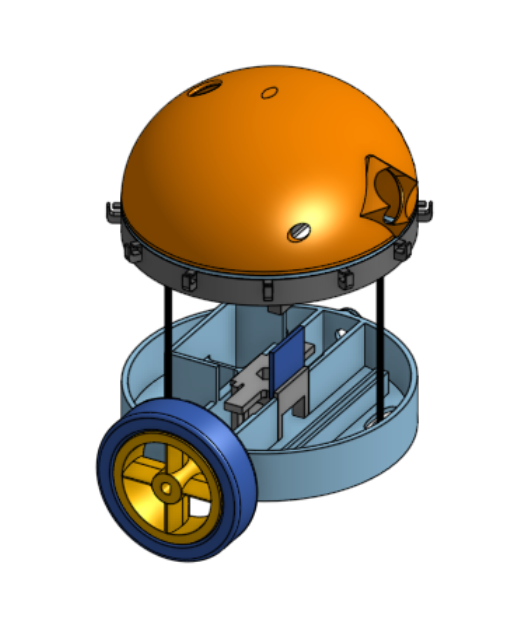
Repeteur/3D/V2/V2_picture.png
