SimonD5/GyroBot/Robot/3D/V2/1Front.png

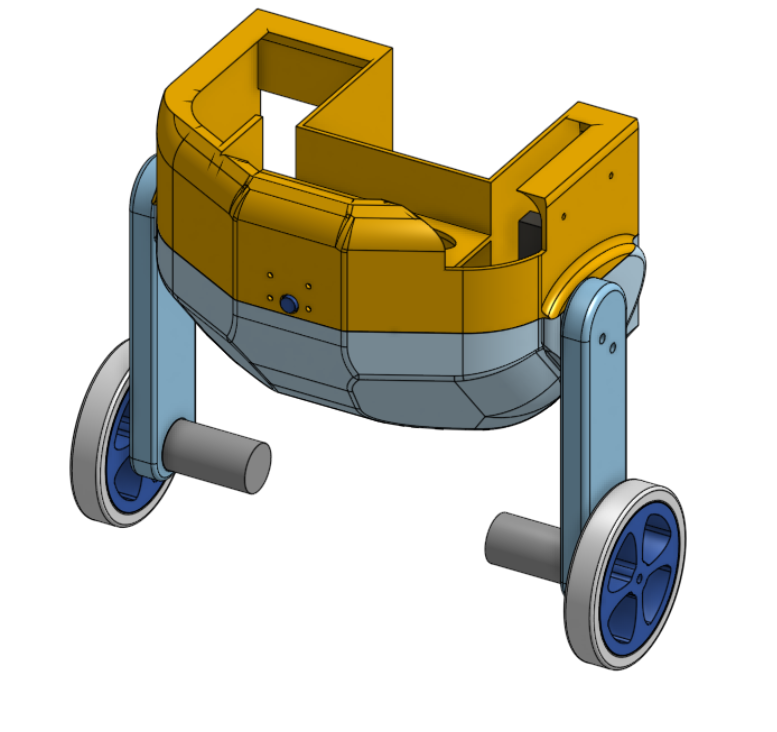
Robot/3D/V2/1Front.png
