SimonD5/GyroBot/Simulation/worlds/.GyroGuin.jpg

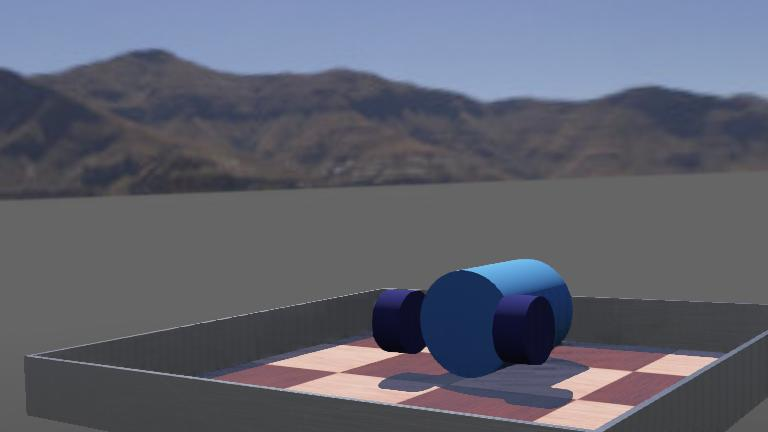
Simulation/worlds/.GyroGuin.jpg
