SimonD5/GyroBot/Robot/Gyrobot_Component_Selection.xlsx

Sheet: Requirements
Needs analysis and I/O specifications
1. Criteria of robot functions (from Specifications and functional analysis table)
Criterion | Level | Tolerance | Unit | Associated function | Selected technical solution | Compliance
2D Map accuracy / precision | 5 | -3 / +5 | cm | FP1 (Capture environment) | Slamtec RPLIDAR C1 (±30 mm accuracy) | YES
LiDAR maximum measurement range | 10 | ± 2 | m | FP1 (Capture environment) | Slamtec RPLIDAR C1 (12 m at 70% reflectivity) | YES
Map refresh rate | 2 | ± 1 | Hz | FP1 / FP3 (HMI display) | RPLIDAR C1 (8 to 12 Hz, typical 10 Hz) | YES
Nominal travel speed | 4 | ± 2 | km/h | FP2 (Movement in environment) | DFRobot FIT0521 (210 RPM) + Custom 70-90 mm 3D wheels (~2.8 to 3.5 km/h) | YES
Minimum turning radius | 0.5 | ± 0.2 | m | FP2 (Movement in environment) | Differential drive 2 wheels (spot turn R = 0 m) | YES
Maximum climbable slope | > 30 | / | ° | FS2 (Terrain adaptation) | FIT0521 34:1 gear ratio (10 kg·cm stall torque) + high-grip TPU 3D tires | YES
Wheel slip | None | / | / | FS2 (Ground grip) | Custom 3D printed wheels with TPU 95A high-friction tread | YES
Tip-over / Fall | None | / | / | FC1 (Self-balancing on 2 wheels) | 200 Hz PID loop on ESP32-C6 + LSM6DSOX IMU (Thrust > 43N guarantees a > 4.4g) | YES
Balance control loop frequency | 200 | / | Hz | FC1 (Inverted pendulum stability) | ESP32-C6 real-time task (5 ms period, jitter < 50 µs) | YES
Command response time | < 50 | / | ms | FP4 (Remote control) | ESP-NOW 2.4 GHz protocol (latency < 5 ms) | YES
Remote control radio range (indoor) | > 30 | / | m | FP4 (Remote control) | ESP-NOW 2.4 GHz (> 40 m indoors) | YES
Remote control radio range (outdoor) | > 150 | / | m | FP4 (Remote control) | ESP-NOW 2.4 GHz (> 200 m line-of-sight) | YES
Bandwidth robot -> Remote control | > 30 | / | kbps | FP4 (Telemetry feedback) | ESP-NOW frame (up to 1 Mbps payload bandwidth) | YES
Bandwidth robot -> PC HMI | > 2 | / | Mbps | FP3 (Real-time HMI feedback) | Wi-Fi 802.11ac Raspberry Pi 5 (> 50 Mbps actual) | YES
Display / video latency | < 100 | / | ms | FP3 (User experience) | Sony IMX219 hardware H.264 encode + WebRTC | YES
Maximum total robot weight | < 1.5 | / | kg | FS1 (Mass budget management) | Total estimated mass: ~1.05 kg (450 g safety margin) | YES
Center of Gravity (CoG) position | Centered above wheel axis | / | / | FS1 (Mechanical balancing) | 3S Battery & Raspberry Pi 5 vertically centered | YES
Minimum operational autonomy | > 3 | / | min | FC3 (Electrical power supply) | 3S 2700 mAh LiPo: > 60 min active drive (>20x margin) | YES
Nominal supply voltage | 11.1 (3S) | / | V | FC3 (Electrical power supply) | Beez2B 3S LiPo battery (11.1V nom. / 12.6V max) | YES
Battery replacement time | < 1 | / | min | FP5 / FC8 (Easy maintenance) | Tool-free battery compartment with XT60 connector | YES
2. Input/Output needs of the robot (Dual-board architecture : ESP32-C6 + Raspberry Pi 5 8GB)
Connected element | Host board | No. of elements | Analog channels | Digital inputs | Digital outputs | I2C pins | UART pins | MIPI CSI port | Total pins | Role and details
Motor driver MDD10A (PWM) | ESP32-C6 | 2 | 0 | 0 | 2 | 0 | 0 | 0 | 2 | 20 kHz PWM signals (left and right motor speed, software clamped to ~55% for 6V)
Motor driver MDD10A (DIR) | ESP32-C6 | 2 | 0 | 0 | 2 | 0 | 0 | 0 | 2 | Direction control signals (left and right motors)
Integrated quadrature encoders FIT0521 | ESP32-C6 | 2 | 0 | 4 | 0 | 0 | 0 | 0 | 4 | Channels A & B (11 PPR x 34.02 = 374 PPR, 1496 counts/rev in 4x) for precise odometry
IMU sensor LSM6DSOX | ESP32-C6 | 1 | 0 | 0 | 0 | 2 | 0 | 0 | 2 | Fast I2C bus (SDA, SCL) at 400 kHz for 200 Hz loop
Inter-board serial link | ESP32-C6 | 1 | 0 | 0 | 0 | 0 | 2 | 0 | 2 | Hardware UART at 921600 baud to Raspberry Pi 5 8GB
Battery 3S voltage sensing | ESP32-C6 | 1 | 1 | 0 | 0 | 0 | 0 | 0 | 1 | Analog ADC via precision divider (100k/22k)
Status / diagnostic LED | ESP32-C6 | 1 | 0 | 0 | 1 | 0 | 0 | 0 | 1 | Balance state and radio link status indicator
LiDAR scanner RPLIDAR C1 | Raspberry Pi 5 8GB | 1 | 0 | 0 | 0 | 0 | 2 | 0 | 2 | TTL UART at 460800 baud (or USB bridge)
Camera module Pi v2.1 | Raspberry Pi 5 8GB | 1 | 0 | 0 | 0 | 0 | 0 | 1 | 1 | MIPI CSI-2 2-lane via SC1128 20 cm ribbon cable
Inter-board serial link | Raspberry Pi 5 8GB | 1 | 0 | 0 | 0 | 0 | 2 | 0 | 2 | UART0 (GPIO 14/15) to exchange commands & odometry
3. Summary of processing specifications and hardware allocation
Indicator | Required value | Hardware allocation | Comment
Balance control loop rate | 200 Hz (T = 5 ms) | ESP32-C6 (RISC-V) | Deterministic hard real-time execution with jitter < 50 µs, guaranteed outside Linux OS
IMU data acquisition | 200 Hz (ODR 208 Hz) | ESP32-C6 | Complementary filter / EKF pitch attitude estimation from LSM6DSOX data
Remote control command reception | 50 Hz (T = 20 ms) | ESP32-C6 | ESP-NOW frame from ESP32-S3 remote control (radio latency < 5 ms)
LiDAR telemetry acquisition | 5,000 points / s (10 Hz) | Raspberry Pi 5 8GB | Continuous 460800 baud stream decoded by Slamtec ROS2 driver node
Simultaneous 2D SLAM mapping | Real-time (> 2 Hz) | Raspberry Pi 5 8GB | Cartographer / Hector SLAM running across 4x Cortex-A76 at 2.4 GHz + 8GB RAM
High-resolution video stream to HMI | 1080p at 30 fps | Raspberry Pi 5 8GB | Sony IMX219 hardware ISP encode, low-latency RTSP/WebRTC stream to PC HMI
High-speed data link to PC HMI | > 2 Mbps (typ. 50 Mbps) | Raspberry Pi 5 8GB | Dual-band 802.11ac Wi-Fi transmitting to the Penguin HMI application
Physical GPIOs used on ESP32-C6 | 13 pins | ESP32-C6 DevKitC-1 | DevKitC-1 provides 22 usable GPIOs -> 9 spare GPIOs margin

Sheet: Component Selection
Component selection and justifications
No. | Function performed | Component selected | Reference / model | Main characteristics (Datasheet) | Justification of choice | Alternatives considered | Alternative drawbacks | Qty | Unit price (€) | Total price (€) | Status / Procurement
1 | High-level compute & SLAM mapping | Single Board Computer (SBC) | Raspberry Pi 5 (8GB) | Quad-core Arm Cortex-A76 at 2.4 GHz, 8GB LPDDR4X, 2x MIPI CSI/DSI 4-lane, Wi-Fi 802.11ac, USB 3.0 | Provided by Polytech. Essential computing power and generous 8GB RAM to run Cartographer 2D SLAM, filter 5000 pts/s from LiDAR, encode 1080p H.264 video, and serve the PC HMI (> 2 Mbps) without memory bottlenecks. | Raspberry Pi 4B (8GB) NVIDIA Jetson Nano Raspberry Pi 5 (4GB) | Pi 4B: CPU saturation under simultaneous SLAM and video. Jetson: excessive power draw (> 15W), significantly heavier. Pi 5 4GB: tighter memory buffer during extended SLAM mapping. | 1 | 216.00 € | 0.00 € | PROVIDED (Polytech)
2 | Real-time balance & radio control | Microcontroller | ESP32-C6-DevKitC-1 V2.1 | 32-bit RISC-V core at 160 MHz, Wi-Fi 6 2.4 GHz, BLE 5, 802.15.4, native ESP-NOW, hardware LEDC PWM, 12-bit ADC | Provided by Polytech. Guarantees strict 200 Hz balance PID loop (5 ms period, zero OS jitter). Supports native low-latency ESP-NOW link with ESP32-S3 remote control (< 5 ms). | Raspberry Pi 5 alone (Linux) Arduino Nano / STM32F4 | Pi 5 alone: Linux non-RTOS scheduler causes balance jitter and robot tipping. Arduino: 8-bit too slow, no native Wi-Fi for ESP-NOW. | 1 | 11.90 € | 0.00 € | PROVIDED (Polytech)
3 | 360° Laser rangefinding for mapping | 360° LiDAR scanner | Slamtec RPLIDAR C1 (Code 38763) | DToF technology, 0.05 to 12 m range, ±30 mm resolution, 5000 samples/s, 8-12 Hz scan rate (typ. 10 Hz), UART 460800 bps, 5V / 230 mA, IP54 | Matches all CdCF criteria: range > 10 m (up to 12 m), accuracy ±3 cm (< 5 cm required), scan rate 10 Hz (> 2 Hz required). Compact (110 g) and IP54 rated. | RPLIDAR A1M8 (Triangulation) Single-point ToF / Ultrasonic | A1M8: triangulation vulnerable to ambient sunlight, limited to 6m. Single ToF: no 360° panoramic field of view. | 1 | 83.90 € | 83.90 € | PURCHASED (GoTronic)
4 | Attitude estimation & Dynamic balance | 6 DoF IMU Module | Adafruit LSM6DSOX (ADA4438) | 3-axis accel (±2 to ±16g) + 3-axis gyro (±125 to ±2000 dps), ultra-low noise 3.8 mdps/√Hz, I2C/SPI Qwiic, 0.55 mA | Core component for 2-wheel self-balancing (FC1). Ultra-low gyroscopic drift and high immunity to motor mechanical vibrations. | MPU-6050 (obsolete) BNO055 (internal fusion) | MPU-6050: high thermal drift, end-of-life. BNO055: internal fusion blocking, 3x higher cost. | 1 | 14.50 € | 14.50 € | PURCHASED (GoTronic)
5 | Propulsion, dynamic balancing & odometry | 6V Metal DC Gearmotor with Integrated Encoder | DFRobot FIT0521 (Code GoTronic 35841) | 6V DC (PWM clamped ~50-55% via MDD10A), 34:1 all-metal gearbox, no-load speed 210 RPM, stall torque 10 kg·cm (0.98 N·m), stall current 3.2A, integrated Hall quadrature encoder (11 PPR motor / 374 PPR output, 1496 counts/rev in 4x), 4 mm D-shaft, Ø 24.4 x 52 mm | Solves the lack of matched motor pair at FabLab. Multiplies stall torque by 3.3x (10 kg·cm vs 3 kg·cm) as recommended by professor to maximize safety margin against tipping. Slower 210 RPM speed prevents tire slip and LiDAR distortion. Integrated 1496 ticks/rev quadrature encoders enable high-precision odometry (< 0.2 mm/tick) and real-time balance loop without external brackets. | DFRobot FIT0482 (Micro N20 6V 50:1) Sha Yang Ye IG-22 12V 1:19 Pololu 25D 12V with encoder | N20 FIT0482: torque too low (0.8 kg·cm) for a 1.0 kg robot. IG-22: unavailable in matched pair, no encoders. Pololu 25D: exceeds budget (> 60 € for pair). | 2 | 21.50 € | 43.00 € | PURCHASED (GoTronic)
6 | Motor power H-bridge | Dual Motor Driver 2x10A | Cytron MDD10A (Code 38327) | Dual NMOS H-bridge, 5V to 30V DC, 10A cont / 30A peak per channel, PWM up to 20 kHz, 3.3V/5V logic, test buttons | Silent ultrasonic 20 kHz PWM. Effortlessly drives 6V FIT0521 motors via PWM duty cycle clamping (~55%). Handles motor stall currents (3.2A) with zero heat dissipation (no heatsink needed). Integrated manual test buttons simplify bench validation. | Shield L298N (bipolar) TB6612FNG (1.2A) | L298N: bipolar bridge loses 2-3V as heat, terrible efficiency. TB6612: 1.2A limit is too tight for stall currents. | 1 | 29.20 € | 29.20 € | PURCHASED (GoTronic)
7 | Vision & Remote inspection | High-resolution camera | Raspberry Pi Camera v2.1 (E305654) | Sony IMX219 8 Megapixels, 1080p at 30 fps, 720p at 60 fps, adjustable focus lens, MIPI CSI-2 interface | Provided by Polytech. Provides real-time video feedback on PC HMI. Fulfills the requirement for camera/LiDAR versatility for remote inspection of confined spaces. | Standard USB webcam Raspberry Pi HQ Camera | USB webcam: heavy CPU load on USB bus. HQ Camera: bulky and heavy external lens assembly. | 1 | 29.90 € | 0.00 € | PROVIDED (Polytech)
8 | Camera ribbon cable | CSI / MIPI 20 cm ribbon cable | SC1128 cable for Pi 5 (Code 38646) | 20 cm length, 22-pin 0.5 mm pitch to 15-pin 1.0 mm pitch, shielded flexible flat cable | Mandatory adapter cable to connect Camera v2.1 (15-pin 1 mm connector) to Raspberry Pi 5 new high-density mini-CSI port (22-pin 0.5 mm). | Standard Pi 3/4 cable USB cable extension | Standard Pi 3/4 cable: physically incompatible with Pi 5 mini-CSI socket. | 1 | 1.60 € | 1.60 € | PURCHASED (GoTronic)
9 | Ground contact and dynamic mobility | Custom Parametric 3D Printed Wheels | Ø 70 to 90 mm (Nominal 80 mm) PETG/TPU Wheels | Rigid PETG rim with 4 mm D-shaft hub + M3 grub screw brass insert. Flexible TPU 95A outer tread (or rubber O-ring) for maximum floor grip. Parametric CAD design (scalable from 70 to 90 mm). | Designed on CAD and 3D printed at FabLab (0 €). The 70-90 mm diameter range combined with the 10 kg·cm torque of the FIT0521 motors delivers a massive horizontal thrust of 43.6 N to 56.0 N (acceleration 4.4 g to 5.7 g, far above the 1.0 g / 9.81 m/s² critical tipping threshold). Ensures 23 to 33 mm ground clearance and up to ±25° tilt angle before chassis contact. | Commercial robot wheels 65 mm (FIT0385) Large 120 mm wheels | Commercial wheels: fixed size, extra cost. 120 mm wheels: excessive rotational inertia, decreases dynamic torque response. | 2 | 0.00 € | 0.00 € | 3D Printed
10 | Main 5V voltage regulation | 5A Step-Down Buck Converter | DFRobot DFR0205 (Code 31698) | High-efficiency buck converter, input 3.6-25V, selectable 5V fixed / adjustable, 5A continuous (25W), 88% efficiency, terminal + pin headers | Powers the 5V rail (Raspberry Pi 5 8GB, LiDAR, ESP32, sensors) from the 11.1V battery with 60% headroom (nominal load ~2A vs 5A capacity). Prevents Pi 5 undervoltage throttles. | LM7805 linear regulator LM2596 module (3A) | LM7805: dissipates ~15W as pure heat. LM2596: limited to 2-3A max, causes brownouts on Pi 5. | 1 | 9.70 € | 9.70 € | PURCHASED (GoTronic)
11 | Onboard energy storage | LiPo 3S 11.1V 30C Battery | Beez2B 3S 2700 mAh 30C | 11.1V nominal (12.6V max), 2700 mAh (29.97 Wh), 30C continuous (81A), XT60 connector, JST-XH balance lead, ~205g | Provided by Polytech. Direct 11.1V supply to Cytron MDD10A. 81A continuous capacity guarantees zero voltage sag. Provides > 60 min runtime (well above 3 min requirement). | NiMH 10x 1.2V pack 18650 Li-ion 3S1P LiPo 2S (7.4V) | NiMH: poor energy density (too heavy). 18650: weak peak discharge (< 10A). 2S: voltage too low for motors. | 1 | 29.90 € | 0.00 € | PROVIDED (Polytech)
 | TOTAL |  |  |  |  |  |  | 13 |  | 181.90 €

Sheet: Architecture Comparison
Comparison of control and processing architectures
Architectures considered and Compliance with CdCF elimination criteria
Evaluation criterion | Unit | ESP32-C6 + RPi 5 8GB | Raspberry Pi 5 8GB alone | STM32F4 + Wi-Fi | Arduino Mega + RPi 3B
Strict 200 Hz balance PID loop capability | Hz | 200 Hz guaranteed (Hard RTOS) | Unstable (Linux scheduler jitter) | 200 Hz guaranteed | 100 Hz max (8-bit CPU saturated)
2D SLAM computation capacity (Cartographer) | MIPS / FLOPS | Excellent (4x A76 at 2.4 GHz + 8GB) | Excellent (4x A76 + 8GB) | Impossible (no FPU/RAM) | Insufficient (RPi 3B throttles)
Simultaneous 5 kHz LiDAR + 1080p Camera | - | YES (dedicated MIPI bus + DMA) | YES (shared CPU) | NO (no CSI bus) | Partial (framerate drops)
Remote control link latency | ms | < 5 ms (ESP-NOW direct) | > 40 ms (Wi-Fi TCP/IP) | 10-20 ms (external module) | > 50 ms
Video and telemetry data rate to PC HMI | Mbps | > 50 Mbps (Wi-Fi 802.11ac) | > 50 Mbps | < 1 Mbps (UART/SPI) | ~15 Mbps (Wi-Fi n)
Meets the balance criterion (FC1 : no tip-over) ? | - | YES | NO (risk of fall) | YES | NO
Meets the SLAM mapping criterion (FP1 : 5 cm) ? | - | YES | YES | NO | PARTIAL
Meets the total weight limit (< 1.5 kg) ? | - | YES | YES | YES | NO (too heavy)
Compliant with all Gyrobot CdCF requirements ? | - | YES | NO (Eliminated FC1) | NO (Eliminated FP1) | NO (Eliminated FC1/FP1)

Sheet: Energy Balance
Energy Balance, sizing and autonomy
1. Power supply parameters
Parameter | Value | Unit | Comment & Technical source
Nominal battery voltage | 11.10 | V | Beez2B 3S LiPo pack (3x 3.7V nominal)
Full charge battery voltage | 12.60 | V | Full charge at 4.20V per cell
Cutoff voltage (safety) | 9.90 | V | Low safety threshold at 3.30V per cell (prevents cell damage)
Battery nominal capacity | 2700 | mAh | Beez2B 3S LiPo battery selected
Nominal energy stored | 29.97 | Wh | Capacity x Nominal voltage = 2.7 Ah x 11.1 V
Continuous discharge rating | 30 | C | Max continuous discharge current = 30C x 2.7 A = 81 A
Usable capacity fraction | 80.0% | - | Assumption: 80% DoD (standard LiPo safety margin)
Usable capacity | 2160 | mAh | 2700 mAh x 80% usable depth
DFR0205 output voltage | 5.00 | V | Regulated 5V rail for Raspberry Pi 5 8GB, LiDAR and sensors
Converter efficiency | 88.0% | - | Typical 88% efficiency (85-92% under 2-3A load at 11.1V)
Max DFR0205 continuous current | 5000 | mA | Manufacturer rating: 5.0 A (25 W)
2. Element power consumption
Element | Qty | Power rail | Unit current (mA) | Total current (mA) | Power (mW) | Operating mode / Datasheet source
Raspberry Pi 5 8GB (Cartographer SLAM + Wi-Fi HMI) | 1 | 5V rail (DFR0205) | 1550 | 1550 | 7750 | Active 4-core under ROS2 + continuous 802.11ac Wi-Fi + 8GB RAM (typ. 1.55A, peak 2.3A)
Slamtec RPLIDAR C1 (360° laser scanner) | 1 | 5V rail (DFR0205) | 230 | 230 | 1150 | Continuous 10 Hz rotation and laser ranging (5000 pts/s)
Pi Camera v2.1 (Sony IMX219) | 1 | 5V rail (via RPi) | 180 | 180 | 900 | Powered at 3.3V (250 mA) via internal Pi 5 LDO, reflected on 5V rail
ESP32-C6-DevKitC-1 | 1 | 5V rail (DFR0205) | 70 | 70 | 350 | Active 200 Hz PID loop + continuous ESP-NOW RX/TX (peak 160 mA)
IMU LSM6DSOX (ADA4438) | 1 | 5V rail (DFR0205) | 1 | 1 | 5 | High performance combo mode accel + gyro at 208 Hz (0.55 mA datasheet)
Cytron MDD10A control logic | 1 | 5V rail (DFR0205) | 5 | 5 | 25 | Internal logic and input optocoupler buffers
DFRobot FIT0521 DC motors (Balancing mode) | 2 | 11.1V rail (via MDD10A) | 160 | 320 | 3552 | Pendulum balance on flat surface (PWM ~25-30% at 6V eq, ~160 mA avg from 11.1V per motor)
DFRobot FIT0521 DC motors (Cruise ~3 km/h) | 2 | 11.1V rail (via MDD10A) | 260 | 520 | 5772 | Active cruising travel at ~3 km/h on flat ground (~260 mA avg from 11.1V per motor)
DFRobot FIT0521 DC motors (Slope > 30° / Peak) | 2 | 11.1V rail (via MDD10A) | 550 | 1100 | 12210 | High-torque climbing on 30° inclined ramp (~550 mA avg from 11.1V per motor)
3. Results and Autonomy Calculation
Performance indicator | Value | Unit | Comments
Total current on the 5V rail | 2036 | mA | Sum of RPi 5 8GB (1550) + LiDAR (230) + Camera (180) + ESP32 (70) + IMU (1) + Driver (5)
Total power on the 5V rail | 10.18 | W | P = U x I = 5.0 V x 2.036 A
Current drawn from battery (5V rail) | 1042 | mA | I_bat(5V) = P_5V / (Efficiency x V_bat) = 10.18 / (0.88 x 11.1)
Motor battery current (Balancing mode) | 320 | mA | 2x FIT0521 motors in pendulum stabilization = 2x 160 mA from 11.1V
Total battery current (Balancing mode) | 1362 | mA | Sum of 5V rail (1042 mA) + Balancing motors (320 mA)
Total power (Balancing mode) | 15.12 | W | P_total = 11.1 V x 1.362 A
Estimated autonomy (Balancing mode) | 1.59 h | h | Usable capacity (2160 mAh) / 1362 mA = 95.2 minutes (1h 35min)
Total battery current (Cruise ~3 km/h) | 1562 | mA | Sum of 5V rail (1042 mA) + Cruising motors (520 mA)
Total power (Cruise ~3 km/h) | 17.34 | W | P_total = 11.1 V x 1.562 A
Estimated autonomy (Cruise ~3 km/h) | 1.38 h | h | Usable capacity (2160 mAh) / 1562 mA = 83.0 minutes (1h 23min)
Total battery current (Slope > 30°) | 2142 | mA | Sum of 5V rail (1042 mA) + Slope climbing motors (1100 mA)
Estimated autonomy (Slope > 30°) | 1.01 h | h | Usable capacity (2160 mAh) / 2142 mA = 60.5 minutes (1h 00min)
Minimum required autonomy | > 3 | min | Specifications: Table 1 (p.14) 'Minimum autonomy > 3 min'
Autonomy compliance | YES | - | Actual autonomy (60 to 95 min) exceeds minimum requirement by > 20x !
DFR0205 max continuous current | 5000 | mA | Manufacturer rating: 5.0 A continuous
DFR0205 current margin | 59.3% | % | (5000 - 2036) / 5000 = 59.3% safety margin available
Voltage margin Vbattery_min - Voutput | 4.90 | V | At full discharge: 9.9V - 5.0V = 4.9V (well above 1.5V dropout requirement)
Sufficient voltage margin ? | YES (COMPLIANT) | - | Buck regulator maintains rock-solid 5.0V output down to cutoff
