SimonD5/GyroBot/Documentation/Excel/Commande projet.xlsx

Noms des étudiants : | HAAS Maud, DRAPEAU Simon, VANPEPERSTRAETE--BOURGUEIL Alexandre, BEN HADDOU Issam
Nom du tuteur enseignant : | M. LEGROS Quentin
Nom du projet : | Gyrobot, 4A GPSE
Date de la demande : | 2026-10-07
Nom du fournisseur | Nom générique du produit | Référence de l'article | Quantité | Prix unitaire HT | Lien internet vers le produit
GOTRONIC | Motoréducteur + encodeur FIT0521 | 35841 | 2 | 17.92 € | https://www.gotronic.fr/art-motoreducteur-encodeur-fit0521-27897.htm
GOTRONIC | Module 6 DoF LSM6DSOX ADA4438 | 36626 | 1 | 12.08 € | Module 6 DoF LSM6DSOX ADA4438 | Gotronic (https://www.gotronic.fr/art-module-6-dof-lsm6dsox-ada4438-31240.htm)
GOTRONIC | Capteur de distance RPLIDAR C1 | 38763 | 1 | 69.92 € | https://www.gotronic.fr/art-capteur-de-distance-rplidar-c1-38898.htm
GOTRONIC | Commande moteur CC 2x10 A MDD10A | 38327 | 1 | 24.33 € | https://www.gotronic.fr/art-commande-moteur-cc-2x10-a-mdd10a-37250.htm
GOTRONIC | Nappe 20 cm CSI / MIPI caméra SC1128 | 38646 | 1 | 1.33 € | https://www.gotronic.fr/art-nappe-20-cm-csi-mipi-camera-sc1128-38454.htm
GOTRONIC | Alimentation 3,3 à 25 V DFR0205 | 31698 | 1 | 8.08 € | https://www.gotronic.fr/art-alimentation-3-3-a-25-v-dfr0205-19341.htm
GOTRONIC | Carte XIAO ESP32-C3 113991054 | 37859 | 1 | 4.92 € | https://www.gotronic.fr/art-carte-xiao-esp32c3-35643.htm
