SimonD5/GyroBot/Repeteur/Code/RobotBalance_PID_Tuner/SessionTest/PID_session_v3_wifi_20261011_182428_resume.csv

trial | Kp | Ki | Kd | setpoint | pwmMin | duration_s | rms_error_deg | max_error_deg | max_rate_deg_s | max_pwm | mean_pwm | mean_dt_ms | max_dt_ms | oscillations | outcome | recommendation
1 | 15.0 | 1.0 | 0.3 | 2.5 | 11 | 2.335 | 4.713122116545474 | 18.79 | 98.1 | 200 | 52.44230769230769 | 5.0 | 8.401 | 2 | CHUTE | Le robot corrige mais oscille encore fortement. Augmente Kd de 10 à 20 % avant de toucher à Ki.
2 | 15.0 | 1.0 | 0.3 | 2.5 | 11 | 2.055 | 5.097767072573402 | 18.85 | 105.7 | 200 | 61.567961165048544 | 4.999970873786408 | 8.563 | 2 | CHUTE | Le robot corrige mais oscille encore fortement. Augmente Kd de 10 à 20 % avant de toucher à Ki.
3 | 15.0 | 1.0 | 0.3 | 2.5 | 11 | 3.145 | 3.410181859880836 | 17.5 | 75.6 | 200 | 33.1936507936508 | 4.999947619047619 | 7.297 | 4 | CHUTE | Oscillations nombreuses/instables. Kp semble trop haut ou le D insuffisant. Premier essai conseillé : Kp -10 %, Kd inchangé.
4 | 15.0 | 1.0 | 0.3 | 2.5 | 11 | 1.815 | 5.163788114582907 | 19.25 | 87.4 | 200 | 55.87637362637363 | 4.99993956043956 | 7.409 | 1 | CHUTE | Le contrôleur arrive presque à la saturation PWM. Avant d'augmenter Kp, vérifie la consigne, le sens moteur et la zone morte.
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
