SimonD5/GyroBot/Repeteur/Code/RobotBalance_PID_Tuner/02_Moteurs_6V_500RPM/Sessions_Tests_500RPM/PID_session_v3_wifi_20261020_185039_resume.csv

trial | Kp | Ki | Kd | setpoint | pwmMin | duration_s | rms_error_deg | max_error_deg | max_rate_deg_s | max_pwm | mean_pwm | mean_dt_ms | max_dt_ms | oscillations | outcome | recommendation
1 | 13.0 | 1.0 | 0.1 | 1.35 | 28 | 44.995 | 0.5822295748051431 | 1.8900000000000001 | 57.3 | 45 | 12.388444444444444 | 4.999996222222222 | 8.45 | 70 | TRES BON | Réglage prometteur. Fais 3 essais identiques pour vérifier la répétabilité avant de modifier les gains.
2 | 13.0 | 1.0 | 0.1 | 1.35 | 28 | 44.995 | 0.5737802424854542 | 1.92 | 49.7 | 46 | 12.25088888888889 | 4.999996888888889 | 9.054 | 70 | TRES BON | Réglage prometteur. Fais 3 essais identiques pour vérifier la répétabilité avant de modifier les gains.
3 | 13.0 | 1.0 | 0.1 | 1.35 | 28 | 44.995 | 0.5890622491157733 | 1.79 | 57.3 | 43 | 12.550777777777778 | 4.999993777777778 | 8.744 | 67 | TRES BON | Réglage prometteur. Fais 3 essais identiques pour vérifier la répétabilité avant de modifier les gains.
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
