SimonD5/GyroBot/Repeteur/Code/RobotBalance_PID_Tuner/02_Moteurs_6V_500RPM/Sessions_Tests_500RPM/PID_session_v3_wifi_20261018_184348_resume.csv

trial | Kp | Ki | Kd | setpoint | pwmMin | duration_s | rms_error_deg | max_error_deg | max_rate_deg_s | max_pwm | mean_pwm | mean_dt_ms | max_dt_ms | oscillations | outcome | recommendation
1 | 15.0 | 0.0 | 0.0 | 0.3 | 28 | 8.854 | 2.520475048383927 | 18.93 | 306.5 | 200 | 34.13261851015801 | 5.000000564334086 | 8.813 | 22 | CHUTE | Bonne tenue mais erreur encore importante. Teste une petite hausse de Kd puis vérifie l'angle moyen.
2 | 15.0 | 0.0 | 0.0 | 0.3 | 28 | 2.595 | 4.169286002330708 | 18.68 | 96.5 | 200 | 51.136538461538464 | 4.999978846153846 | 6.321 | 2 | CHUTE | Le robot corrige mais oscille encore fortement. Augmente Kd de 10 à 20 % avant de toucher à Ki.
3 | 15.0 | 0.0 | 0.3 | 0.3 | 28 | 3.334 | 3.220320468859534 | 18.39 | 146.2 | 200 | 48.73652694610779 | 4.999943113772455 | 7.687 | 2 | CHUTE | Le robot corrige mais oscille encore fortement. Augmente Kd de 10 à 20 % avant de toucher à Ki.
4 | 15.0 | 1.0 | 0.3 | 0.3 | 28 | 2.474 | 3.7612732165687484 | 20.19 | 276.9 | 200 | 54.336693548387096 | 4.999895161290323 | 8.635 | 19 | CHUTE | Oscillations nombreuses/instables. Kp semble trop haut ou le D insuffisant. Premier essai conseillé : Kp -10 %, Kd inchangé.
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
