SimonD5/GyroBot/Repeteur/Code/RobotBalance_PID_Tuner/01_Moteurs_6V_300RPM/Sessions_Tests_300RPM/PID_session_v3_wifi_20261014_154526_resume.csv

trial | Kp | Ki | Kd | setpoint | pwmMin | duration_s | rms_error_deg | max_error_deg | max_rate_deg_s | max_pwm | mean_pwm | mean_dt_ms | max_dt_ms | oscillations | outcome | recommendation
1 | 15.0 | 1.0 | 0.3 | 2.5 | 11 | 1.614 | 6.939851147583591 | 18.74 | 72.6 | 200 | 68.92283950617283 | 4.999932098765432 | 5.677 | 1 | CHUTE | Le contrôleur arrive presque à la saturation PWM. Avant d'augmenter Kp, vérifie la consigne, le sens moteur et la zone morte.
2 | 15.0 | 0.0 | 0.0 | 0.0 | 18 | 2.64 | 5.330984935082056 | 18.24 | 83.3 | 200 | 49.119092627599244 | 4.99318336483932 | 5.544 | 2 | CHUTE | Le robot corrige mais oscille encore fortement. Augmente Kd de 10 à 20 % avant de toucher à Ki.
3 | 15.0 | 0.0 | 0.0 | -1.0 | 18 | 2.154 | 4.1303582763170485 | 17.04 | 80.6 | 200 | 36.648148148148145 | 4.999875 | 5.042 | 3 | CHUTE | Oscillations nombreuses/instables. Kp semble trop haut ou le D insuffisant. Premier essai conseillé : Kp -10 %, Kd inchangé.
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
