SimonD5/GyroBot/Repeteur/Code/RobotBalance_PID_Tuner/01_Moteurs_6V_300RPM/Sessions_Tests_300RPM/PID_session_wifi_20261011_172136_resume.csv

trial | Kp | Ki | Kd | setpoint | pwmMin | duration_s | rms_error_deg | max_error_deg | max_rate_deg_s | max_pwm | mean_pwm | mean_dt_ms | max_dt_ms | oscillations | outcome | recommendation
1 | 15.0 | 1.0 | 0.3 | 2.5 | 11 | 29.995 | 0.5287845181798222 | 1.9100000000000001 | 49.3 | 34 | 9.138833333333332 | 5.0 | 8.748 | 35 | TRES BON | Réglage prometteur. Fais 3 essais identiques pour vérifier la répétabilité avant de modifier les gains.
2 | 15.0 | 1.0 | 0.3 | 2.5 | 11 | 11.304 | 2.555625095480011 | 18.5 | 153.6 | 200 | 27.45844385499558 | 4.999999557913351 | 8.741 | 58 | CHUTE | Bonne tenue mais erreur encore importante. Teste une petite hausse de Kd puis vérifie l'angle moyen.
3 | 15.0 | 1.0 | 0.3 | 2.5 | 11 | 18.319 | 1.7576224561888476 | 18.74 | 156.5 | 200 | 18.22155525238745 | 5.000000272851296 | 8.754 | 60 | CHUTE | Bonne tenue mais erreur encore importante. Teste une petite hausse de Kd puis vérifie l'angle moyen.
4 | 15.0 | 1.0 | 0.3 | 2.5 | 11 | 12.574 | 2.3839068613703 | 19.23 | 162.1 | 200 | 22.89864864864865 | 4.999998807631161 | 8.744 | 50 | CHUTE | Bonne tenue mais erreur encore importante. Teste une petite hausse de Kd puis vérifie l'angle moyen.
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
