SimonD5/GyroBot/Robot/gyrobot schematic.pdf

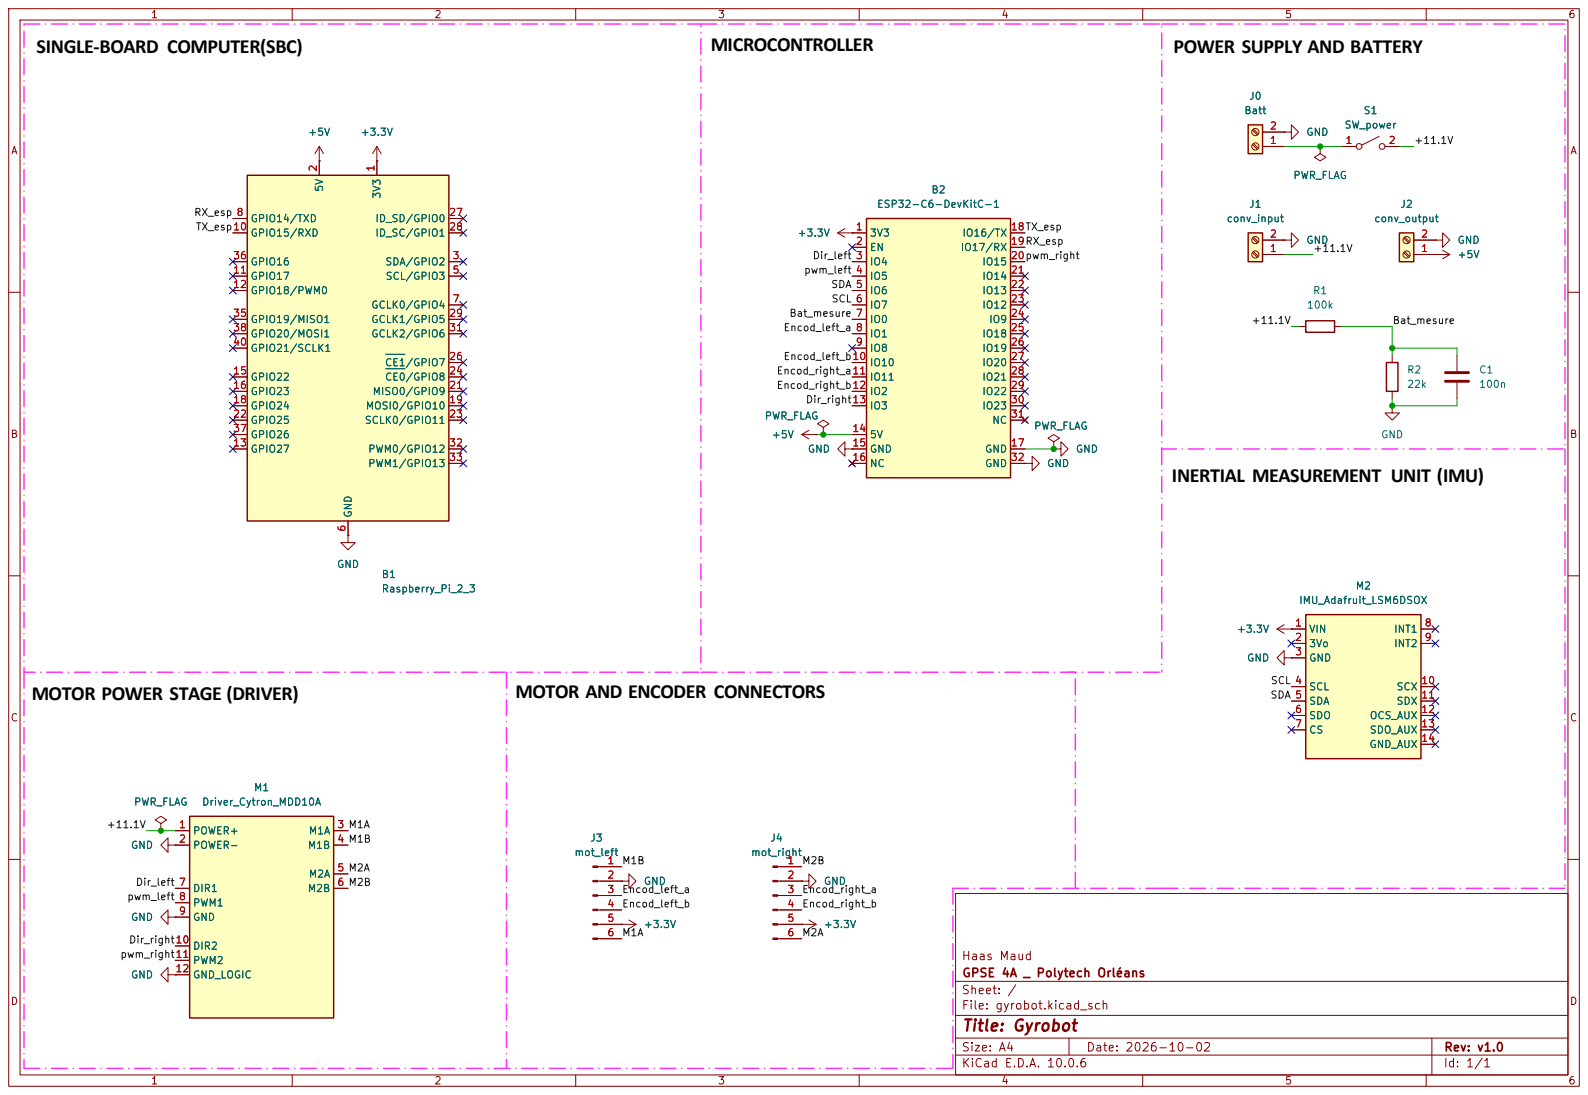
[picture p43: page 1]

SINGLE-BOARD COMPUTER(SBC)

INERTIAL MEASUREMENT UNIT (IMU)

MOTOR POWER STAGE (DRIVER)

MOTOR AND ENCODER CONNECTORS

Size: A4 | Rev: v1.0
KiCad E.D.A. 10.0.6 | Id: 1/1
