SimonD5/GyroBot/Robot/motor_and_elec_schematic/schema_elec.pdf

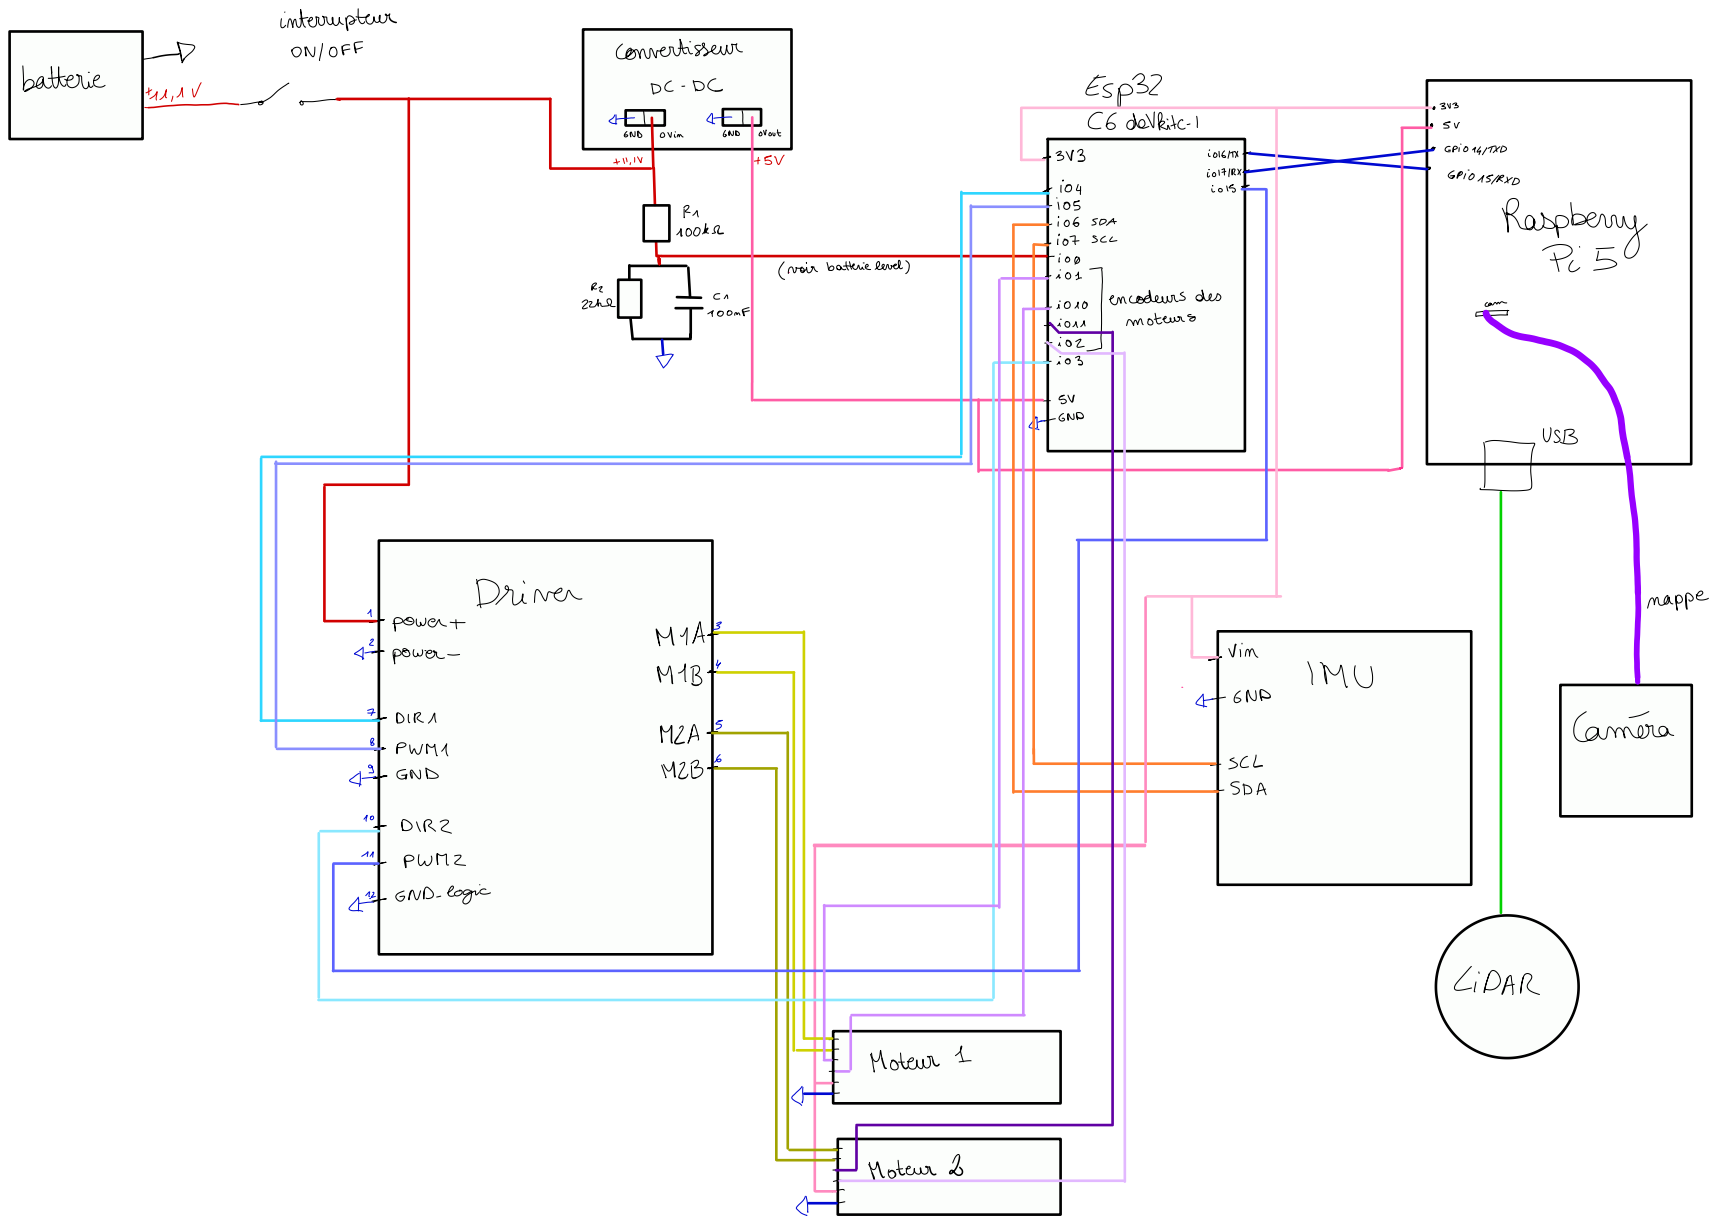
[picture p44: page 1]
