SimonD5/GyroBot/(commit log)

2026-09-10 Upload New File for Use case
2026-09-13 maj des modif demander par prof
2026-10-18 Revise README for motor 500 RPM benefits and usage
    Updated README to reflect changes in motor specifications and tuning instructions.
2026-10-18 Revise PID tuning parameters and clean up README
    Updated the README to reflect the correct parameters for PID tuning and removed outdated sections regarding motor testing.
2026-10-20 create file
    veille LiDAR
2026-10-21 Update README with PWM and consumption details
2026-11-02 Add files via upload
    PCB
2026-11-09 LiDAR update
